edarn/kryp-client/Web/SurfVind_web/Surfvind/design/ws_speed.png

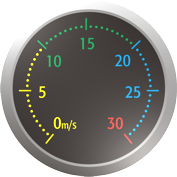
Web/SurfVind_web/Surfvind/design/ws_speed.png
