edarn/kryp-client/PCB/main_board_1_3 with gerbers/Gerber Files/INFO.txt

[B]Main board v1.3.GBL - copper bottom layer
[B]Main board v1.3.GTL - copper top layer
[B]Main board v1.3.GBS - soldermask bottom layer
[B]Main board v1.3.GTS - soldermask top layer
[B]Main board v1.3.GTO - silkscreen top layer
[B]Main board v1.3.GBO - silkscreen bottom layer
[B]Main board v1.3.gpi - gerber info

[B]Main board v1.3.drd - drill files
[B]Main board v1.3.dri - drill info
