edarn/kryp-client/Android/Logger/DataLogger/raw_images/tumblr_static_arrow.jpg

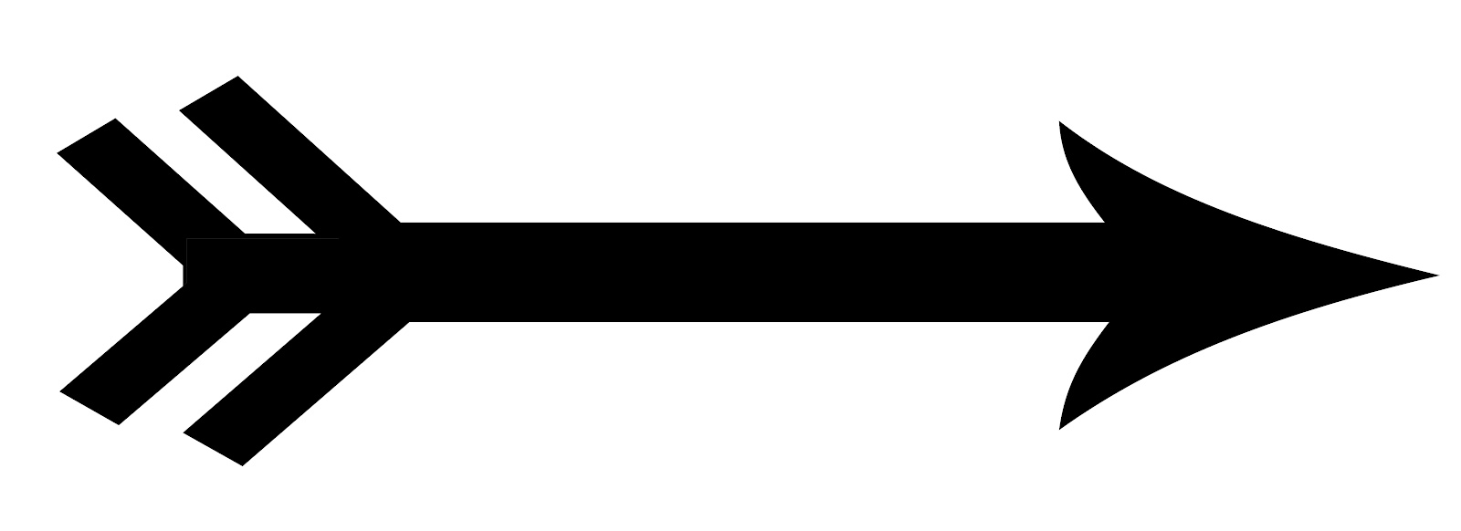
Android/Logger/DataLogger/raw_images/tumblr_static_arrow.jpg
