edarn/kryp-client/Android/Logger/DataLogger/raw_images/ws_compass.png

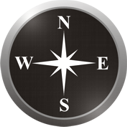
Android/Logger/DataLogger/raw_images/ws_compass.png
