edarn/kryp-client/Web/SurfVind_web/Surfvind/Applet/12345/graph_2.png

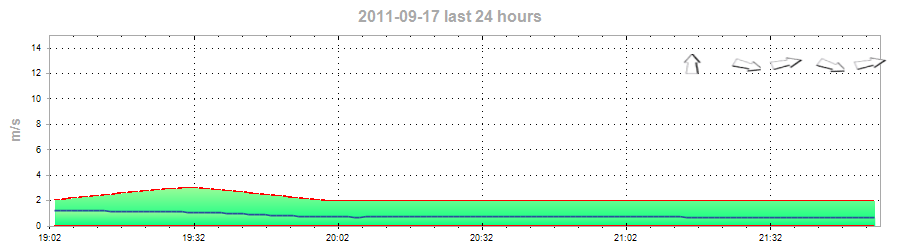
Web/SurfVind_web/Surfvind/Applet/12345/graph_2.png
