edarn/kryp-client/Web/SurfVind_web/Surfvind/Applet/354745031074596/graph_4.png

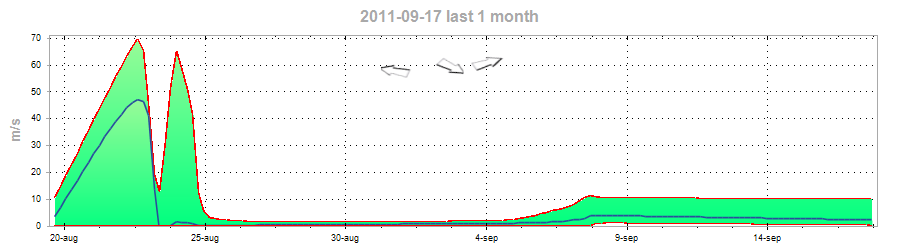
Web/SurfVind_web/Surfvind/Applet/354745031074596/graph_4.png
