edarn/kryp-client/Web/SurfVind_web/Surfvind/design/chart.png

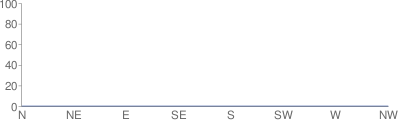
Web/SurfVind_web/Surfvind/design/chart.png
