edarn/kryp-client/Web/SurfVind_web/Surfvind/design/ws_background_sea.png

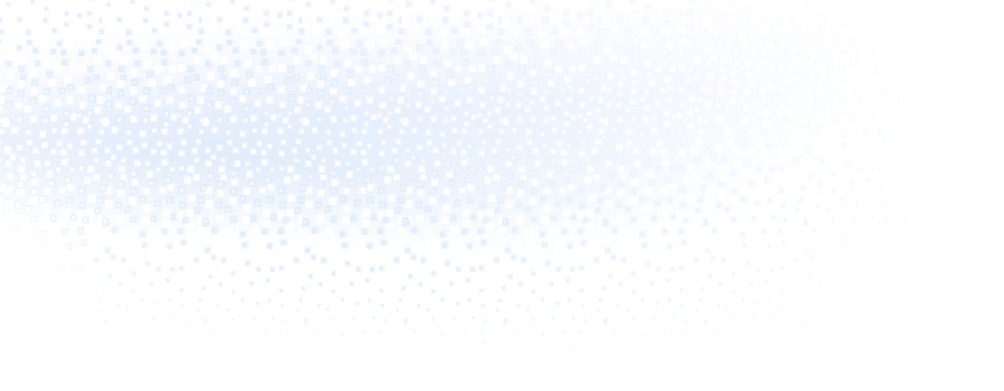
Web/SurfVind_web/Surfvind/design/ws_background_sea.png
