edarn/kryp-client/Web/SurfVind_web/Surfvind/design/ws_graph.png

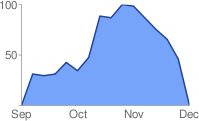
Web/SurfVind_web/Surfvind/design/ws_graph.png
