edarn/kryp-client/Web/SurfVind_web/Surfvind/design/ws_head.png

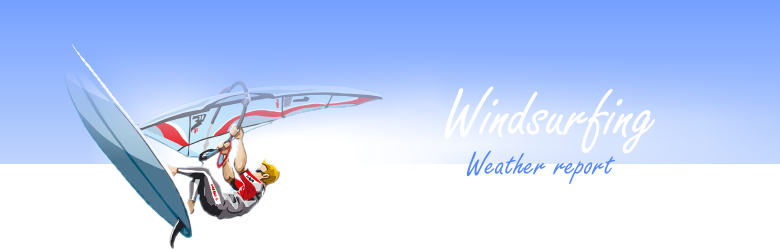
Web/SurfVind_web/Surfvind/design/ws_head.png
