edarn/kryp-client/Web/SurfVind_web/Surfvind/Images/12345_img_compass.png

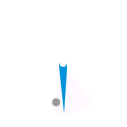
Web/SurfVind_web/Surfvind/Images/12345_img_compass.png
