edarn/kryp-client/Web/SurfVind_web/Surfvind/Images/12345_img_speed.png

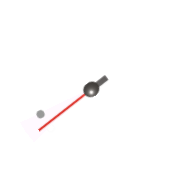
Web/SurfVind_web/Surfvind/Images/12345_img_speed.png
