edarn/kryp-client/Web/SurfVind_web/Surfvind/Images/12345_WindDirectionChart.png

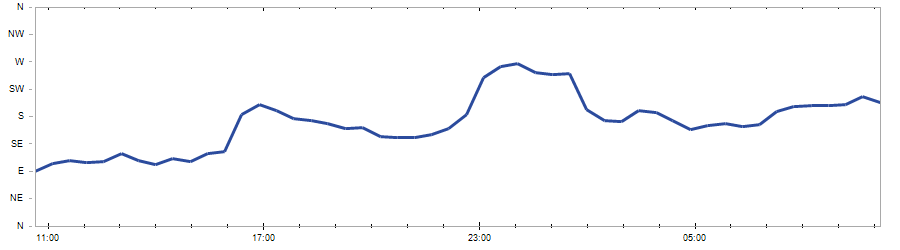
Web/SurfVind_web/Surfvind/Images/12345_WindDirectionChart.png
