edarn/kryp-client/Web/SurfVind_web/Surfvind/Images/12345_WindSpeedChart.png

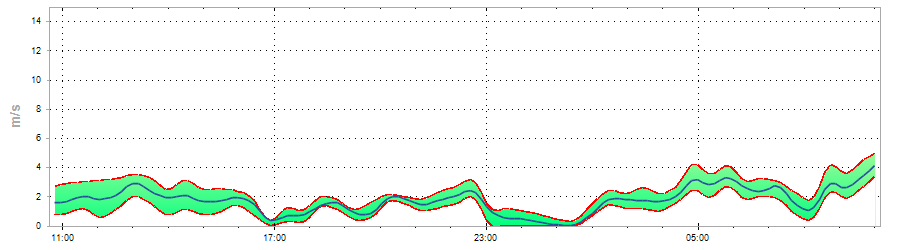
Web/SurfVind_web/Surfvind/Images/12345_WindSpeedChart.png
