edarn/kryp-client/Web/SurfVind_web/Surfvind/Images/354745030513008_img_compass.png

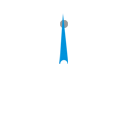
Web/SurfVind_web/Surfvind/Images/354745030513008_img_compass.png
