edarn/kryp-client/Web/SurfVind_web/Surfvind/Images/354745030513008_WindDirectionChart.png

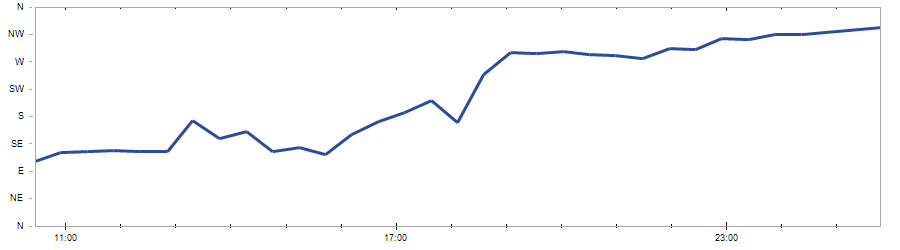
Web/SurfVind_web/Surfvind/Images/354745030513008_WindDirectionChart.png
