edarn/kryp-client/Web/SurfVind_web/Surfvind/Images/354745030513008_WindSpeedChart.png

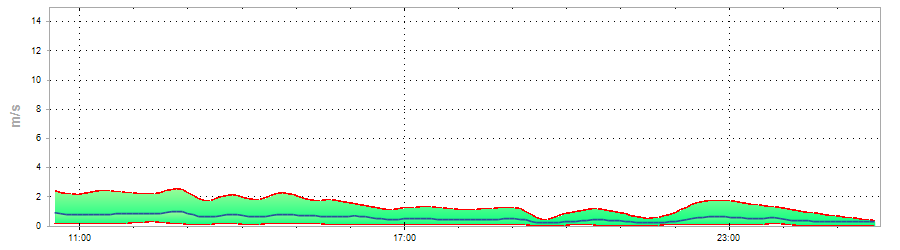
Web/SurfVind_web/Surfvind/Images/354745030513008_WindSpeedChart.png
