edarn/kryp-client/Web/SurfVind_web/Surfvind/Images/354745031035159_img_compass.png

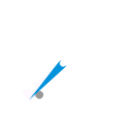
Web/SurfVind_web/Surfvind/Images/354745031035159_img_compass.png
