edarn/kryp-client/Web/SurfVind_web/Surfvind/Images/354745031074596_img_speed.png

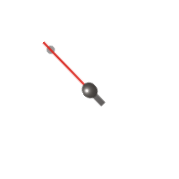
Web/SurfVind_web/Surfvind/Images/354745031074596_img_speed.png
