edarn/kryp-client/Web/SurfVind_web/Surfvind/Images/_WindDirectionChart.png

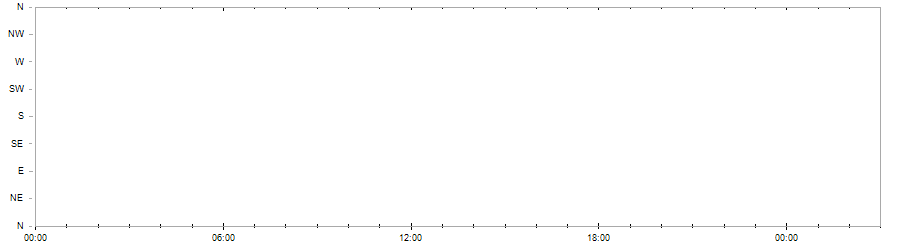
Web/SurfVind_web/Surfvind/Images/_WindDirectionChart.png
