edarn/kryp-client/Web/SurfVind_web/Surfvind/Images/img_compass.png

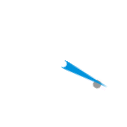
Web/SurfVind_web/Surfvind/Images/img_compass.png
