edarn/kryp-client/Web/SurfVind_web/Surfvind/Images/WindSpeedChart.png

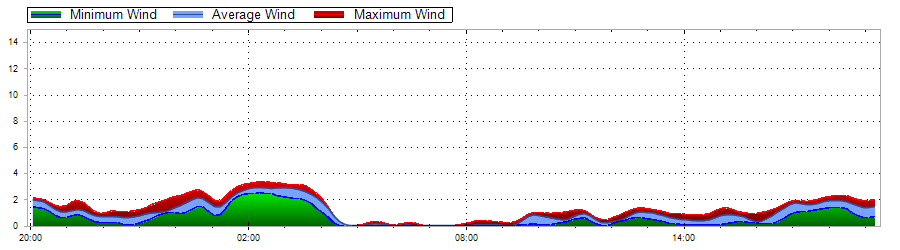
Web/SurfVind_web/Surfvind/Images/WindSpeedChart.png
