edarn/kryp-client/Web/Vindinfo_web/Applet/12345/graph_0.png

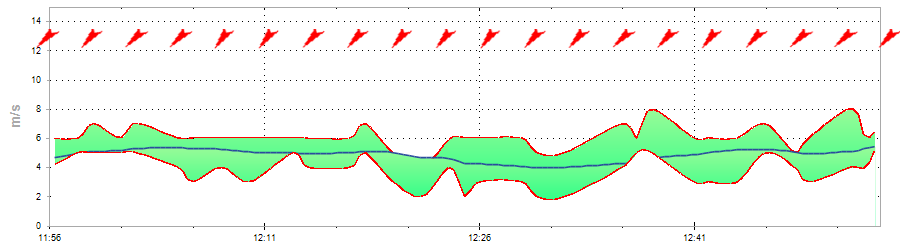
Web/Vindinfo_web/Applet/12345/graph_0.png
