edarn/kryp-client/Web/Vindinfo_web/Applet/12345/graph_4.png

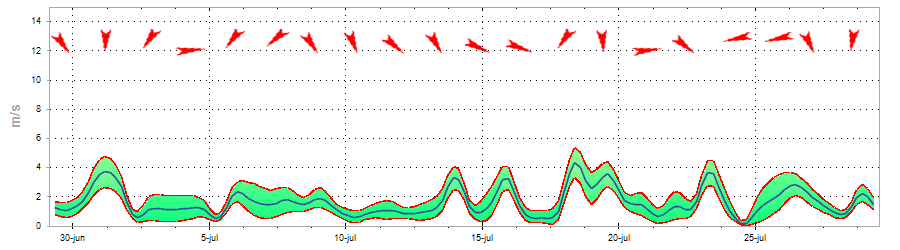
Web/Vindinfo_web/Applet/12345/graph_4.png
