edarn/kryp-client/Web/Vindinfo_web/Applet/354745030513008/graph_0.png

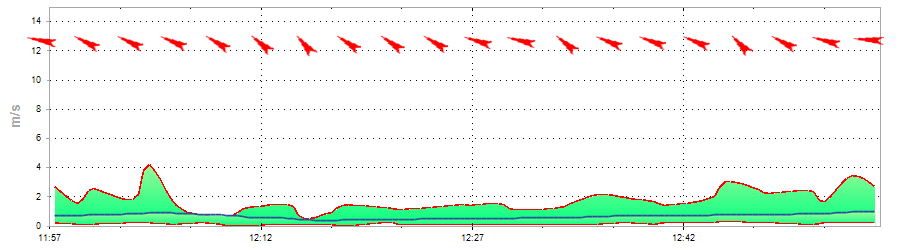
Web/Vindinfo_web/Applet/354745030513008/graph_0.png
