edarn/kryp-client/Web/Vindinfo_web/Applet/354745030513008/graph_4.png

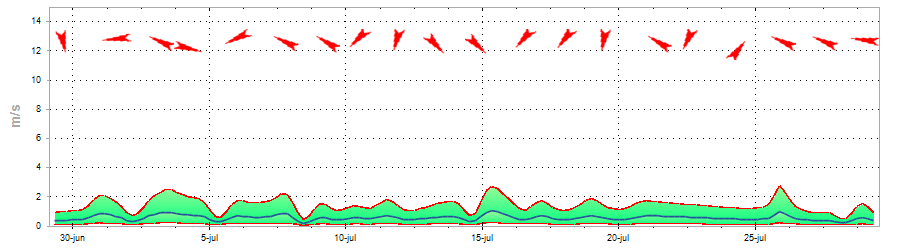
Web/Vindinfo_web/Applet/354745030513008/graph_4.png
