edarn/kryp-client/Web/Vindinfo_web/Applet/354745031035159/graph_4.png

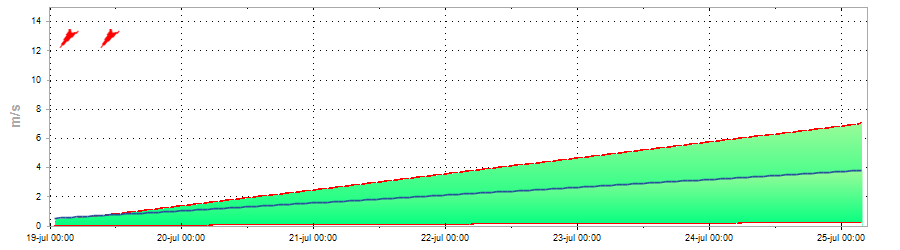
Web/Vindinfo_web/Applet/354745031035159/graph_4.png
