edarn/kryp-client/Web/Vindinfo_web/design/back.png

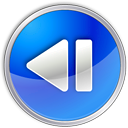
Web/Vindinfo_web/design/back.png
