edarn/kryp-client/Web/Vindinfo_web/design/flower.jpg

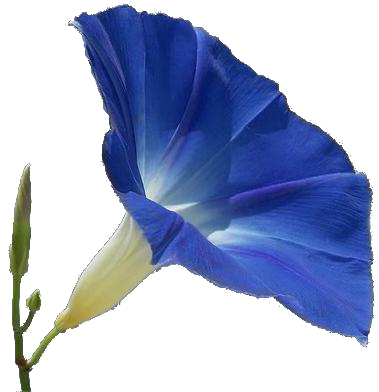
Web/Vindinfo_web/design/flower.jpg
