edarn/kryp-client/Web/Vindinfo_web/design/forward.png

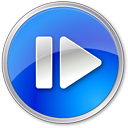
Web/Vindinfo_web/design/forward.png
