edarn/kryp-client/Web/Vindinfo_web/design/Weather.gif

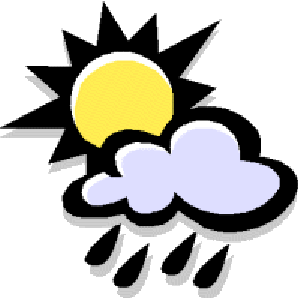
Web/Vindinfo_web/design/Weather.gif
