edarn/kryp-client/Web/Vindinfo_web/Images/12345_img_speed.png

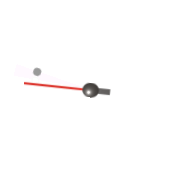
Web/Vindinfo_web/Images/12345_img_speed.png
