edarn/kryp-client/Web/Vindinfo_web/Images/354745030513008_img_compass.png

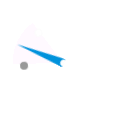
Web/Vindinfo_web/Images/354745030513008_img_compass.png
