edarn/kryp-client/Web/Vindinfo_web/Images/contacts_btn.png

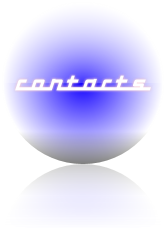
Web/Vindinfo_web/Images/contacts_btn.png
