edarn/kryp-client/Web/Vindinfo_web/Images/FunnyWeatherForecast.jpg

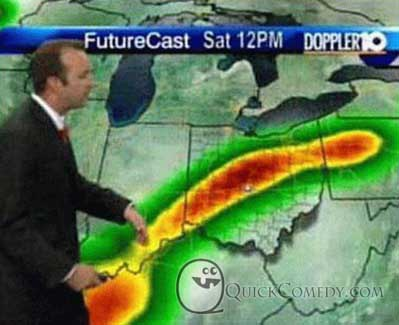
Web/Vindinfo_web/Images/FunnyWeatherForecast.jpg
