edarn/kryp-client/Web/Vindinfo_web/Images/header2.jpg

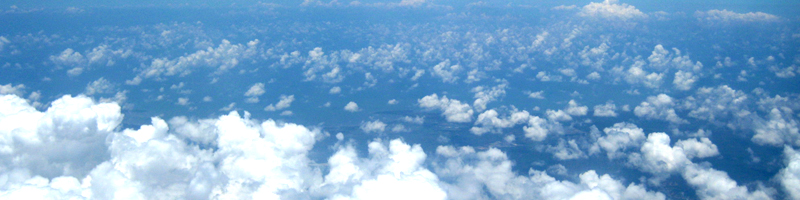
Web/Vindinfo_web/Images/header2.jpg
