edarn/kryp-client/Web/Vindinfo_web/Images/header.jpg

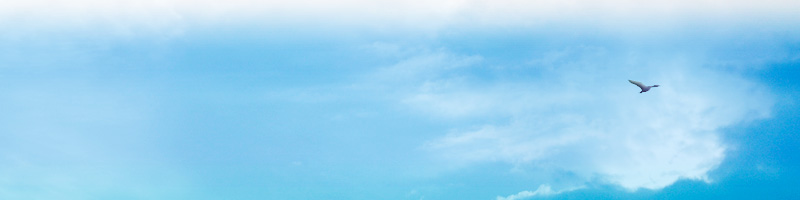
Web/Vindinfo_web/Images/header.jpg
