edarn/kryp-client/Web/Vindinfo_web/Images/kscn1141l.jpg

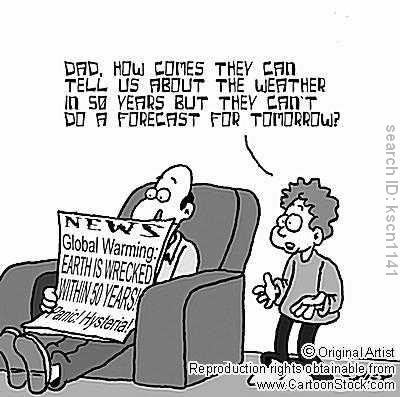
Web/Vindinfo_web/Images/kscn1141l.jpg
