edarn/kryp-client/Web/Vindinfo_web/Images/sun.png

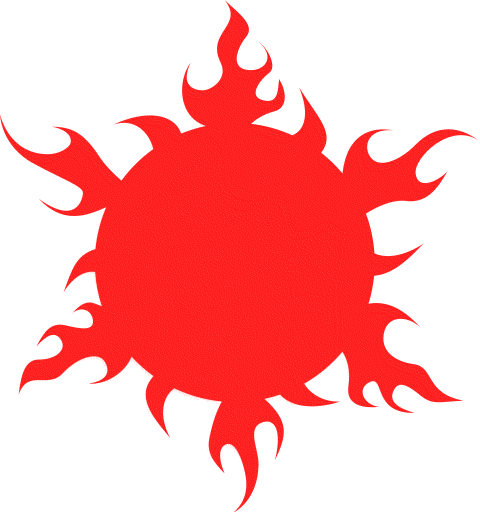
Web/Vindinfo_web/Images/sun.png
