edarn/kryp-client/Web/Vindinfo_web/Images/sun_weather.PNG

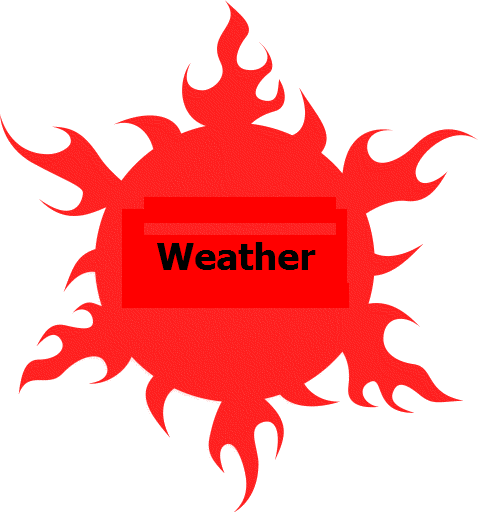
Web/Vindinfo_web/Images/sun_weather.PNG
