edarn/kryp-client/Web/Vindinfo_web/Images/welcome_page1.PNG

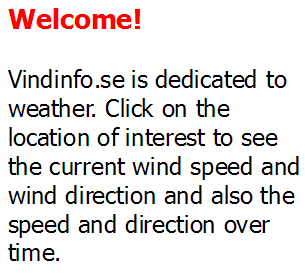
Web/Vindinfo_web/Images/welcome_page1.PNG
