edarn/kryp-client/Web/Vindinfo_web/Images/welcome_page.PNG

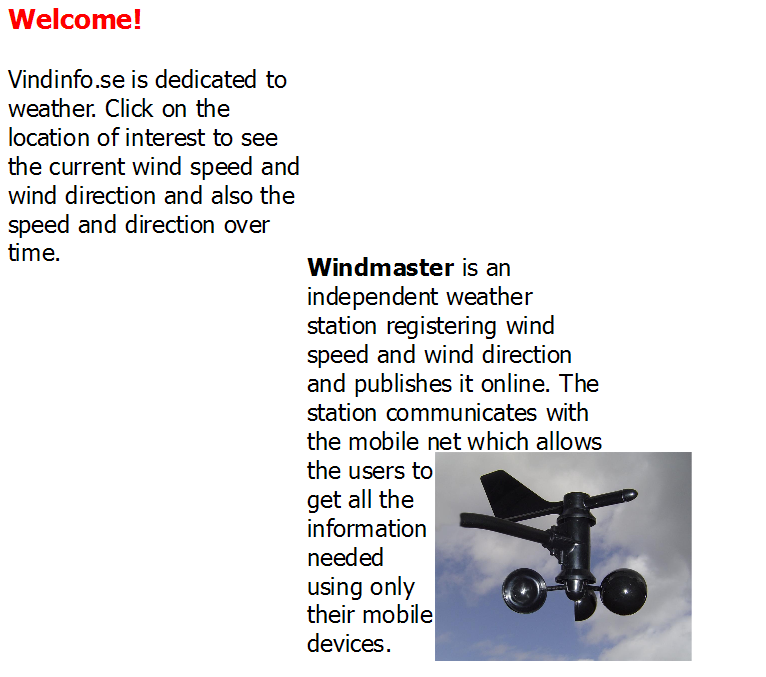
Web/Vindinfo_web/Images/welcome_page.PNG
