edarn/kryp-client/Web/Vindinfo_web/Images/welcome_pic.jpg

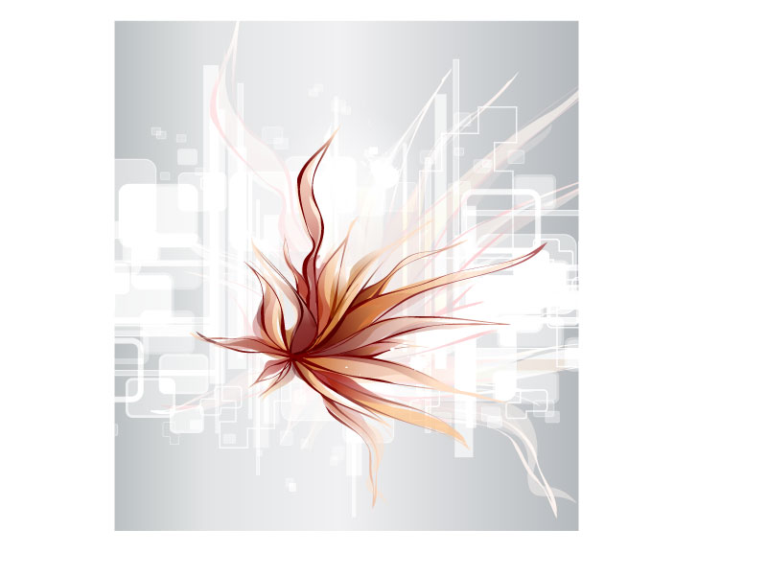
Web/Vindinfo_web/Images/welcome_pic.jpg
