edarn/kryp-client/Web/Vindinfo_web/Images/windmaster1.PNG

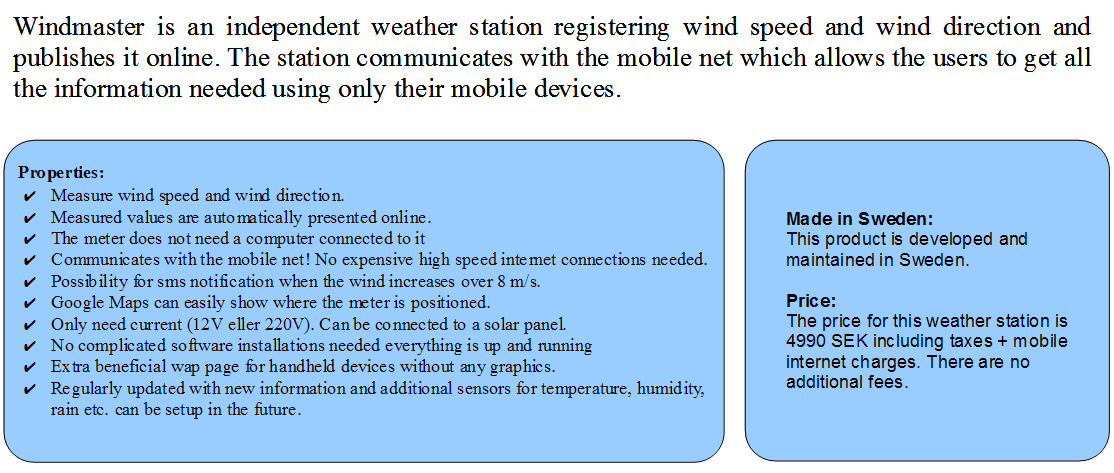
Web/Vindinfo_web/Images/windmaster1.PNG
