edarn/kryp-client/Web/Vindinfo_web/Images/windmaster2.PNG

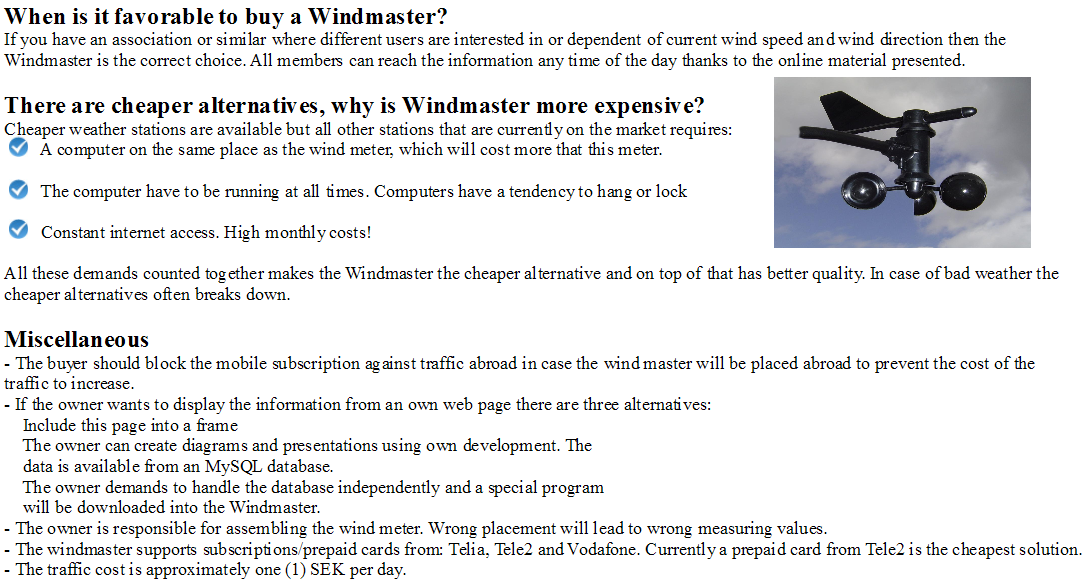
Web/Vindinfo_web/Images/windmaster2.PNG
