edarn/kryp-client/PCB/BOM_Main board v1.3 rev0.1.xls

Sheet: Main board v1.3.xls]I2C
Part | Value | Device | Package | Description | Vendors | Link1
C2 | 10u | C-EUC1206 | C1206 | CAPACITOR, European symbol | TME | http://www.tme.eu/pl/details/c1206c106k4rac/kondensatory-mlcc-smd-1206/kemet/#
C3 | 10u | C-EUC1206 | C1206 | CAPACITOR, European symbol | TME | http://www.tme.eu/pl/details/c1206c106k4rac/kondensatory-mlcc-smd-1206/kemet/#
C4 | 10u | C-EUC1206 | C1206 | CAPACITOR, European symbol | TME | http://www.tme.eu/pl/details/c1206c106k4rac/kondensatory-mlcc-smd-1206/kemet/#
C5 | 100uF/25V | CPOL-EUE2-5 | E2-5 | POLARIZED CAPACITOR, European symbol | TME | http://www.tme.eu/pl/details/sd1e107m05011pc/kondensatory-85c/samwha/#
C11 | 10uF | C-EUC1206 | C1206 | CAPACITOR, European symbol | TME | http://www.tme.eu/pl/details/c1206c106k4rac/kondensatory-mlcc-smd-1206/kemet/#
C12 | 3n3 | C-EUC1206 | C1206 | CAPACITOR, European symbol | TME | http://www.tme.eu/pl/details/12065c332kat2a/kondensatory-mlcc-smd-1206/avx/#
C13 | 10uF | C-EUC1206 | C1206 | CAPACITOR, European symbol | TME | http://www.tme.eu/pl/details/c1206c106k4rac/kondensatory-mlcc-smd-1206/kemet/#
C16 | 10uF | C-EUC1206 | C1206 | CAPACITOR, European symbol | TME | http://www.tme.eu/pl/details/c1206c106k4rac/kondensatory-mlcc-smd-1206/kemet/#
C17 | 100uF/10V/tantal_B | CPOL-EUB/3528-21R | B/3528-21R | POLARIZED CAPACITOR, European symbol | TME | http://www.tme.eu/pl/details/tajb107m010r/kondensatory-tantalowe-smd/avx/tajb107m010rnj/#
C18 | 100n | C-EUC1206 | C1206 | CAPACITOR, European symbol | TME | http://www.tme.eu/pl/details/cl31b104kbcnnnc/kondensatory-mlcc-smd-1206/samsung/#
C19 | 10n | C-EUC1206 | C1206 | CAPACITOR, European symbol | TME | http://www.tme.eu/pl/details/cl31b103kbcnnnc/kondensatory-mlcc-smd-1206/samsung/#
C20 | 100n | C-EUC1206 | C1206 | CAPACITOR, European symbol | TME | http://www.tme.eu/pl/details/cl31b104kbcnnnc/kondensatory-mlcc-smd-1206/samsung/#
C21 | 100n | C-EUC1206 | C1206 | CAPACITOR, European symbol | TME | http://www.tme.eu/pl/details/cl31b104kbcnnnc/kondensatory-mlcc-smd-1206/samsung/#
C22 | 100n | C-EUC1206 | C1206 | CAPACITOR, European symbol | TME | http://www.tme.eu/pl/details/cl31b104kbcnnnc/kondensatory-mlcc-smd-1206/samsung/#
C23 | 100n | C-EUC1206 | C1206 | CAPACITOR, European symbol | TME | http://www.tme.eu/pl/details/cl31b104kbcnnnc/kondensatory-mlcc-smd-1206/samsung/#
C24 | 10uF | C-EUC1206 | C1206 | CAPACITOR, European symbol | TME | http://www.tme.eu/pl/details/c1206c106k4rac/kondensatory-mlcc-smd-1206/kemet/#
C25 | 100n | C-EUC1206 | C1206 | CAPACITOR, European symbol | TME | http://www.tme.eu/pl/details/cl31b104kbcnnnc/kondensatory-mlcc-smd-1206/samsung/#
D1 | 1N4004 | 1N4004 | DO41-10 | DIODE | TME | http://www.tme.eu/pl/details/1n4004/diody-uniwersalne-tht/dc-components/#
D2 | 1N4148DO35-7 | 1N4148DO35-7 | DO35-7 | DIODE | TME | http://www.tme.eu/pl/details/1n4148/diody-uniwersalne-tht/nxp/1n4148113/#
D3 | SS14 | DIODE-SCHOTTKY_ | SMA-DIODE | Commonly MBRA140. | TME | http://www.tme.eu/pl/details/ss14/diody-schottky-smd/dc-components/#
D4 | 1N4148DO35-7 | 1N4148DO35-7 | DO35-7 | DIODE | TME | http://www.tme.eu/pl/details/1n4148/diody-uniwersalne-tht/nxp/1n4148113/#
F1 |  | FUSE_HOLDER | ZHL30 |  | TME | http://www.tme.eu/pl/details/zhl30/bezpieczniki-gniazda-pcb/#t735977d29e6b3d766657895563ce61ae
F2 |  | FUSE_HOLDER | ZHL30 |  | TME | http://www.tme.eu/pl/details/zhl30/bezpieczniki-gniazda-pcb/#t735977d29e6b3d766657895563ce61ae
F3 | PTCSMD | PTCSMD | PTC-1206 | Resettable Fuse PTC | TME | http://www.tme.eu/pl/details/sn075-06/bezpieczniki-polimerowe-smd/ece/#
J1 | 6P_CONN | 6P_CONN | MOLEX_39543-0006 |  | farnell | http://se.farnell.com/molex/39543-0006/terminal-block-eurostyle-6pos-24/dp/1368505?Ntt=1368505
J3 | POWER_JACKPTH | POWER_JACKPTH | PC-GK2.1 | Power Jack | TME | http://www.tme.eu/pl/details/pc-gk2.1/zlacza-dc/#
J4 | RJ11MX-95001-2661 | RJ11MX-95001-2661 | MX-95001-2661 | CORCOM Modular RJ Jacks No Shield | ELFA | https://www.elfa.se/elfa3~se_sv/elfa/init.do?item=42-696-27&toc=0&q=42-696-27
J5 | RJ11MX-95001-2661 | RJ11MX-95001-2661 | MX-95001-2661 | CORCOM Modular RJ Jacks No Shield | ELFA | https://www.elfa.se/elfa3~se_sv/elfa/init.do?item=42-696-27&toc=0&q=42-696-27
J6 | RJ11MX-95001-2661 | RJ11MX-95001-2661 | MX-95001-2661 | CORCOM Modular RJ Jacks No Shield | ELFA | https://www.elfa.se/elfa3~se_sv/elfa/init.do?item=42-696-27&toc=0&q=42-696-27
J7 | 10104111-0001LF | USB_AB | USB-AB-MICRO-SMD | This is a USB AB connector that is compatible with USB OTG. | Mouser | http://pl.mouser.com/ProductDetail/FCI/10104111-0001LF/
JP3 |  | JUMPER-2PTH | 1X02 | Jumper | TME | http://www.tme.eu/pl/details/zl209-40p/listwy-i-gniazda-kolkowe/connfly/ds1021-1_40sf1-5/#
JP4 |  | MA06-1 | MA06-1 | PIN HEADER | TME | http://www.tme.eu/pl/details/zl209-40p/listwy-i-gniazda-kolkowe/connfly/ds1021-1_40sf1-5/#
JP5 |  | JUMPER-2PTH | 1X02 | Jumper | TME | http://www.tme.eu/pl/details/zl209-40p/listwy-i-gniazda-kolkowe/connfly/ds1021-1_40sf1-5/#
K1 | RELAY | RELAY | JV-5S-KT | JV-5S-KT | TME | http://www.tme.eu/pl/details/jv-5s-kt/przekazniki-elektromagn-miniaturowe/fujitsu-takamisawa/#
K2 | RELAY | RELAY | JV-5S-KT | JV-5S-KT | TME | http://www.tme.eu/pl/details/jv-5s-kt/przekazniki-elektromagn-miniaturowe/fujitsu-takamisawa/#
L1 | VLC5045T-3R3N, 3.3uH | INDUCTORCR54 | CR54 | Inductors | Mouser | http://pl.mouser.com/ProductDetail/TDK/VLC5045T-3R3N/
L2 | 30Ohm ,3A | L-US | R1206 | INDUCTOR, American symbol | Mouser | http://pl.mouser.com/ProductDetail/Fair-Rite/2512063007Y0/
LED1 | LS L29K-G1J2-1-Z | LED1206 | LED-1206 | LEDs | TME | http://www.tme.eu/pl/details/osr51206c1c/diody-led-smd-1206/optosupply/#
LED2 | LY L29K-J1K2-26-Z | LED1206 | LED-1206 | LEDs | TME | http://www.tme.eu/pl/details/osr51206c1c/diody-led-smd-1206/optosupply/#
R6 | 0R | R-EU_R1206 | R1206 | RESISTOR, European symbol | TME | http://www.tme.eu/pl/details/rc1206jr-070r/rezystory-smd-1206/yageo/rc1206jr-070rl/#
R7 | 0R | R-EU_R1206 | R1206 | RESISTOR, European symbol | TME | http://www.tme.eu/pl/details/rc1206jr-070r/rezystory-smd-1206/yageo/rc1206jr-070rl/#
R8 | 0R | R-EU_R1206 | R1206 | RESISTOR, European symbol | TME | http://www.tme.eu/pl/details/rc1206jr-070r/rezystory-smd-1206/yageo/rc1206jr-070rl/#
R9 | 0R | R-EU_R1206 | R1206 | RESISTOR, European symbol | TME | http://www.tme.eu/pl/details/rc1206jr-070r/rezystory-smd-1206/yageo/rc1206jr-070rl/#
R10 | 0R | R-EU_R1206 | R1206 | RESISTOR, European symbol | TME | http://www.tme.eu/pl/details/rc1206jr-070r/rezystory-smd-1206/yageo/rc1206jr-070rl/#
R11 | 0R | R-EU_R1206 | R1206 | RESISTOR, European symbol | TME | http://www.tme.eu/pl/details/rc1206jr-070r/rezystory-smd-1206/yageo/rc1206jr-070rl/#
R16 | 24k | R-EU_R1206 | R1206 | RESISTOR, European symbol | TME | http://www.tme.eu/pl/details/rc1206jr-0724k/rezystory-smd-1206/yageo/rc1206jr-0724kl/#
R17 | 4k7 | R-EU_R1206 | R1206 | RESISTOR, European symbol | TME | http://www.tme.eu/pl/details/smd1206-4k7/rezystory-smd-1206/royal-ohm/1206s4j0472t5e/#
R18 | 1k | R-EU_R1206 | R1206 | RESISTOR, European symbol | TME | http://www.tme.eu/pl/details/rc1206jr-071k/rezystory-smd-1206/yageo/rc1206jr-071kl/#
R19 | 4k7 | R-EU_R1206 | R1206 | RESISTOR, European symbol | TME | http://www.tme.eu/pl/details/smd1206-4k7/rezystory-smd-1206/royal-ohm/1206s4j0472t5e/#
R20 | 4k7 | R-EU_R1206 | R1206 | RESISTOR, European symbol | TME | http://www.tme.eu/pl/details/smd1206-4k7/rezystory-smd-1206/royal-ohm/1206s4j0472t5e/#
R21 | 1k | R-EU_R1206 | R1206 | RESISTOR, European symbol | TME | http://www.tme.eu/pl/details/rc1206jr-071k/rezystory-smd-1206/yageo/rc1206jr-071kl/#
R22 | 1k | R-EU_R1206 | R1206 | RESISTOR, European symbol | TME | http://www.tme.eu/pl/details/rc1206jr-071k/rezystory-smd-1206/yageo/rc1206jr-071kl/#
R23 | 100k | R-EU_R1206 | R1206 | RESISTOR, European symbol | TME | http://www.tme.eu/pl/details/rc1206jr-07100k/rezystory-smd-1206/yageo/rc1206jr-07100kl/#
R24 | 4k7 | R-EU_R1206 | R1206 | RESISTOR, European symbol | TME | http://www.tme.eu/pl/details/smd1206-4k7/rezystory-smd-1206/royal-ohm/1206s4j0472t5e/#
R25 | 2k | R-EU_R1206 | R1206 | RESISTOR, European symbol | TME | http://www.tme.eu/pl/details/rc1206jr-072k/rezystory-smd-1206/yageo/rc1206jr-072kl/#
R26 | 470R | R-EU_R1206 | R1206 | RESISTOR, European symbol | TME | http://www.tme.eu/pl/details/rc1206jr-07470r/rezystory-smd-1206/yageo/rc1206jr-07470rl/#
R27 | 100k | R-EU_R1206 | R1206 | RESISTOR, European symbol | TME | http://www.tme.eu/pl/details/rc1206jr-07100k/rezystory-smd-1206/yageo/rc1206jr-07100kl/#
R28 | 10M | R-EU_R1206 | R1206 | RESISTOR, European symbol | TME | http://www.tme.eu/pl/details/smd1206-10m/rezystory-smd-1206/royal-ohm/1206s4j-10m-t5e/#
R29 | 4k7 | R-EU_R1206 | R1206 | RESISTOR, European symbol | TME | http://www.tme.eu/pl/details/smd1206-4k7/rezystory-smd-1206/royal-ohm/1206s4j0472t5e/# | http://www.tme.eu/pl/details/smd1206-4k7/rezystory-smd-1206/royal-ohm/1206s4j0472t5e/#
R30 | 4k7 | R-EU_R1206 | R1206 | RESISTOR, European symbol | TME | http://www.tme.eu/pl/details/smd1206-4k7/rezystory-smd-1206/royal-ohm/1206s4j0472t5e/# | http://www.tme.eu/pl/details/smd1206-4k7/rezystory-smd-1206/royal-ohm/1206s4j0472t5e/#
R31 | 4k7 | R-EU_R1206 | R1206 | RESISTOR, European symbol | TME | http://www.tme.eu/pl/details/smd1206-4k7/rezystory-smd-1206/royal-ohm/1206s4j0472t5e/#
R32 | 4k7 | R-EU_R1206 | R1206 | RESISTOR, European symbol | TME | http://www.tme.eu/pl/details/smd1206-4k7/rezystory-smd-1206/royal-ohm/1206s4j0472t5e/#
R33 | 4k7 | R-EU_R1206 | R1206 | RESISTOR, European symbol | TME | http://www.tme.eu/pl/details/smd1206-4k7/rezystory-smd-1206/royal-ohm/1206s4j0472t5e/#
R34 | 4k7 | R-EU_R1206 | R1206 | RESISTOR, European symbol | TME | http://www.tme.eu/pl/details/smd1206-4k7/rezystory-smd-1206/royal-ohm/1206s4j0472t5e/#
R35 | 4k7 | R-EU_R1206 | R1206 | RESISTOR, European symbol | TME | http://www.tme.eu/pl/details/smd1206-4k7/rezystory-smd-1206/royal-ohm/1206s4j0472t5e/#
R36 | 470R | R-EU_R1206 | R1206 | RESISTOR, European symbol | TME | http://www.tme.eu/pl/details/rc1206jr-07470r/rezystory-smd-1206/yageo/rc1206jr-07470rl/#
R38 | 1k | R-EU_R1206 | R1206 | RESISTOR, European symbol | TME | http://www.tme.eu/pl/details/rc1206jr-071k/rezystory-smd-1206/yageo/rc1206jr-071kl/#
SV1 |  | MA04-1 | MA04-1 | PIN HEADER | TME | http://www.tme.eu/pl/details/zl209-40p/listwy-i-gniazda-kolkowe/connfly/ds1021-1_40sf1-5/#
SV2 |  | MA04-1 | MA04-1 | PIN HEADER | TME | http://www.tme.eu/pl/details/zl209-40p/listwy-i-gniazda-kolkowe/connfly/ds1021-1_40sf1-5/#
SV3 |  | MA04-1 | MA04-1 | PIN HEADER | TME | http://www.tme.eu/pl/details/zl209-40p/listwy-i-gniazda-kolkowe/connfly/ds1021-1_40sf1-5/#
T1 | BC817 | BC817-16-NPN-SOT23-BEC | SOT23-BEC | NPN Transistror | TME | http://www.tme.eu/pl/details/bc817-16/tranzystory-npn-smd/#
T2 | BC817 | BC817-16-NPN-SOT23-BEC | SOT23-BEC | NPN Transistror | TME | http://www.tme.eu/pl/details/bc817-16/tranzystory-npn-smd/#
T3 | IRLML2244 | MOSFET-PCHANNELSMD | SOT23-3 | Generic PMOSFET | TME | http://www.tme.eu/pl/details/irlml2244trpbf/tranzystory-z-kanalem-p-smd/international-rectifier/#
T4 | 2N7002PW | MOSFET-NCHANNELSOT323 | SOT323 | Generic NMOS footprint | Mouser | http://pl.mouser.com/ProductDetail/NXP/2N7002PW115/
U4 | VREG_MIC5216 | VREG_MIC5216 | MSOP8 | 500mA LDO, MSOP8 for better dissipation | Mouser | http://pl.mouser.com/ProductDetail/Micrel/MIC5216-33YMM/
U5 | TPS62133RGTT | TPS6214X | QFN16-3X3MM | 3-17V, 2A Step Down Converter | Mouser | http://pl.mouser.com/ProductDetail/Texas-Instruments/TPS62133RGTT/
U7 | PIC24FJ256GB206 | PIC24FXXXDAX06 | PIC24FXXX_TQFP64 | PIC24FXXXDAX06 | Mouser | http://pl.mouser.com/ProductDetail/Microchip-Technology/PIC24FJ256GB206-I-PT/
U8 | LMC555 | LMC555 | SO08 | General purpose Timer | TME | http://www.tme.eu/pl/details/lmc555cm_nopb/uklady-watchdog-i-reset/texas-instruments/#

Sheet: Main board v1.3.xls]I2C extended
Part | Value | Device | Package | Description | Vendors | Link1
C2 | 10u | C-EUC1206 | C1206 | CAPACITOR, European symbol | TME | http://www.tme.eu/pl/details/c1206c106k4rac/kondensatory-mlcc-smd-1206/kemet/#
C3 | 10u | C-EUC1206 | C1206 | CAPACITOR, European symbol | TME | http://www.tme.eu/pl/details/c1206c106k4rac/kondensatory-mlcc-smd-1206/kemet/#
C4 | 10u | C-EUC1206 | C1206 | CAPACITOR, European symbol | TME | http://www.tme.eu/pl/details/c1206c106k4rac/kondensatory-mlcc-smd-1206/kemet/#
C5 | 100uF/25V | CPOL-EUE2-5 | E2-5 | POLARIZED CAPACITOR, European symbol | TME | http://www.tme.eu/pl/details/sd1e107m05011pc/kondensatory-85c/samwha/#
C8 | 100n | C-EUC1206 | C1206 | CAPACITOR, European symbol | TME | http://www.tme.eu/pl/details/cl31b104kbcnnnc/kondensatory-mlcc-smd-1206/samsung/#
C9 | 100n | C-EUC1206 | C1206 | CAPACITOR, European symbol | TME | http://www.tme.eu/pl/details/cl31b104kbcnnnc/kondensatory-mlcc-smd-1206/samsung/#
C10 | 100n | C-EUC1206 | C1206 | CAPACITOR, European symbol | TME | http://www.tme.eu/pl/details/cl31b104kbcnnnc/kondensatory-mlcc-smd-1206/samsung/#
C11 | 10uF | C-EUC1206 | C1206 | CAPACITOR, European symbol | TME | http://www.tme.eu/pl/details/c1206c106k4rac/kondensatory-mlcc-smd-1206/kemet/#
C12 | 3n3 | C-EUC1206 | C1206 | CAPACITOR, European symbol | TME | http://www.tme.eu/pl/details/12065c332kat2a/kondensatory-mlcc-smd-1206/avx/#
C13 | 10uF | C-EUC1206 | C1206 | CAPACITOR, European symbol | TME | http://www.tme.eu/pl/details/c1206c106k4rac/kondensatory-mlcc-smd-1206/kemet/#
C16 | 10uF | C-EUC1206 | C1206 | CAPACITOR, European symbol | TME | http://www.tme.eu/pl/details/c1206c106k4rac/kondensatory-mlcc-smd-1206/kemet/#
C17 | 100uF/10V/tantal_B | CPOL-EUB/3528-21R | B/3528-21R | POLARIZED CAPACITOR, European symbol | TME | http://www.tme.eu/pl/details/tajb107m010r/kondensatory-tantalowe-smd/avx/tajb107m010rnj/#
C18 | 100n | C-EUC1206 | C1206 | CAPACITOR, European symbol | TME | http://www.tme.eu/pl/details/cl31b104kbcnnnc/kondensatory-mlcc-smd-1206/samsung/#
C19 | 10n | C-EUC1206 | C1206 | CAPACITOR, European symbol | TME | http://www.tme.eu/pl/details/cl31b103kbcnnnc/kondensatory-mlcc-smd-1206/samsung/#
C20 | 100n | C-EUC1206 | C1206 | CAPACITOR, European symbol | TME | http://www.tme.eu/pl/details/cl31b104kbcnnnc/kondensatory-mlcc-smd-1206/samsung/#
C21 | 100n | C-EUC1206 | C1206 | CAPACITOR, European symbol | TME | http://www.tme.eu/pl/details/cl31b104kbcnnnc/kondensatory-mlcc-smd-1206/samsung/#
C22 | 100n | C-EUC1206 | C1206 | CAPACITOR, European symbol | TME | http://www.tme.eu/pl/details/cl31b104kbcnnnc/kondensatory-mlcc-smd-1206/samsung/#
C23 | 100n | C-EUC1206 | C1206 | CAPACITOR, European symbol | TME | http://www.tme.eu/pl/details/cl31b104kbcnnnc/kondensatory-mlcc-smd-1206/samsung/#
C24 | 10uF | C-EUC1206 | C1206 | CAPACITOR, European symbol | TME | http://www.tme.eu/pl/details/c1206c106k4rac/kondensatory-mlcc-smd-1206/kemet/#
C25 | 100n | C-EUC1206 | C1206 | CAPACITOR, European symbol | TME | http://www.tme.eu/pl/details/cl31b104kbcnnnc/kondensatory-mlcc-smd-1206/samsung/#
D1 | 1N4004 | 1N4004 | DO41-10 | DIODE | TME | http://www.tme.eu/pl/details/1n4004/diody-uniwersalne-tht/dc-components/#
D2 | 1N4148DO35-7 | 1N4148DO35-7 | DO35-7 | DIODE | TME | http://www.tme.eu/pl/details/1n4148/diody-uniwersalne-tht/nxp/1n4148113/#
D3 | SS14 | DIODE-SCHOTTKY_ | SMA-DIODE | Commonly MBRA140. | TME | http://www.tme.eu/pl/details/ss14/diody-schottky-smd/dc-components/#
D4 | 1N4148DO35-7 | 1N4148DO35-7 | DO35-7 | DIODE | TME | http://www.tme.eu/pl/details/1n4148/diody-uniwersalne-tht/nxp/1n4148113/#
F1 |  | FUSE_HOLDER | ZHL30 |  | TME | http://www.tme.eu/pl/details/zhl30/bezpieczniki-gniazda-pcb/#t735977d29e6b3d766657895563ce61ae
F2 |  | FUSE_HOLDER | ZHL30 |  | TME | http://www.tme.eu/pl/details/zhl30/bezpieczniki-gniazda-pcb/#t735977d29e6b3d766657895563ce61ae
F3 | PTCSMD | PTCSMD | PTC-1206 | Resettable Fuse PTC | TME | http://www.tme.eu/pl/details/sn075-06/bezpieczniki-polimerowe-smd/ece/#
J1 | 6P_CONN | 6P_CONN | MOLEX_39543-0006 |  | farnell | http://se.farnell.com/molex/39543-0006/terminal-block-eurostyle-6pos-24/dp/1368505?Ntt=1368505
J3 | POWER_JACKPTH | POWER_JACKPTH | PC-GK2.1 | Power Jack | TME | http://www.tme.eu/pl/details/pc-gk2.1/zlacza-dc/#
J4 | RJ11MX-95001-2661 | RJ11MX-95001-2661 | MX-95001-2661 | CORCOM Modular RJ Jacks No Shield | ELFA | https://www.elfa.se/elfa3~se_sv/elfa/init.do?item=42-696-27&toc=0&q=42-696-27
J5 | RJ11MX-95001-2661 | RJ11MX-95001-2661 | MX-95001-2661 | CORCOM Modular RJ Jacks No Shield | ELFA | https://www.elfa.se/elfa3~se_sv/elfa/init.do?item=42-696-27&toc=0&q=42-696-27
J6 | RJ11MX-95001-2661 | RJ11MX-95001-2661 | MX-95001-2661 | CORCOM Modular RJ Jacks No Shield | ELFA | https://www.elfa.se/elfa3~se_sv/elfa/init.do?item=42-696-27&toc=0&q=42-696-27
J7 | 10104111-0001LF | USB_AB | USB-AB-MICRO-SMD | This is a USB AB connector that is compatible with USB OTG. | Mouser | http://pl.mouser.com/ProductDetail/FCI/10104111-0001LF/
JP3 |  | JUMPER-2PTH | 1X02 | Jumper | TME | http://www.tme.eu/pl/details/zl209-40p/listwy-i-gniazda-kolkowe/connfly/ds1021-1_40sf1-5/#
JP4 |  | MA06-1 | MA06-1 | PIN HEADER | TME | http://www.tme.eu/pl/details/zl209-40p/listwy-i-gniazda-kolkowe/connfly/ds1021-1_40sf1-5/#
JP5 |  | JUMPER-2PTH | 1X02 | Jumper | TME | http://www.tme.eu/pl/details/zl209-40p/listwy-i-gniazda-kolkowe/connfly/ds1021-1_40sf1-5/#
K1 | RELAY | RELAY | JV-5S-KT | JV-5S-KT | TME | http://www.tme.eu/pl/details/jv-5s-kt/przekazniki-elektromagn-miniaturowe/fujitsu-takamisawa/#
K2 | RELAY | RELAY | JV-5S-KT | JV-5S-KT | TME | http://www.tme.eu/pl/details/jv-5s-kt/przekazniki-elektromagn-miniaturowe/fujitsu-takamisawa/#
L1 | VLC5045T-3R3N, 3.3uH | INDUCTORCR54 | CR54 | Inductors | Mouser | http://pl.mouser.com/ProductDetail/TDK/VLC5045T-3R3N/
L2 | 30Ohm ,3A | L-US | R1206 | INDUCTOR, American symbol | Mouser | http://pl.mouser.com/ProductDetail/Fair-Rite/2512063007Y0/
LED1 | LS L29K-G1J2-1-Z | LED1206 | LED-1206 | LEDs | TME | http://www.tme.eu/pl/details/osr51206c1c/diody-led-smd-1206/optosupply/#
LED2 | LY L29K-J1K2-26-Z | LED1206 | LED-1206 | LEDs | TME | http://www.tme.eu/pl/details/osr51206c1c/diody-led-smd-1206/optosupply/#
R2 | 2k | R-EU_R1206 | R1206 | RESISTOR, European symbol | TME | http://www.tme.eu/pl/details/rc1206jr-072k/rezystory-smd-1206/yageo/rc1206jr-072kl/#
R3 | 2k | R-EU_R1206 | R1206 | RESISTOR, European symbol | TME | http://www.tme.eu/pl/details/rc1206jr-072k/rezystory-smd-1206/yageo/rc1206jr-072kl/#
R4 | 2k | R-EU_R1206 | R1206 | RESISTOR, European symbol | TME | http://www.tme.eu/pl/details/rc1206jr-072k/rezystory-smd-1206/yageo/rc1206jr-072kl/#
R13 | 2k | R-EU_R1206 | R1206 | RESISTOR, European symbol | TME | http://www.tme.eu/pl/details/rc1206jr-072k/rezystory-smd-1206/yageo/rc1206jr-072kl/#
R14 | 2k | R-EU_R1206 | R1206 | RESISTOR, European symbol | TME | http://www.tme.eu/pl/details/rc1206jr-072k/rezystory-smd-1206/yageo/rc1206jr-072kl/#
R15 | 2k | R-EU_R1206 | R1206 | RESISTOR, European symbol | TME | http://www.tme.eu/pl/details/rc1206jr-072k/rezystory-smd-1206/yageo/rc1206jr-072kl/#
R16 | 24k | R-EU_R1206 | R1206 | RESISTOR, European symbol | TME | http://www.tme.eu/pl/details/rc1206jr-0724k/rezystory-smd-1206/yageo/rc1206jr-0724kl/#
R17 | 4k7 | R-EU_R1206 | R1206 | RESISTOR, European symbol | TME | http://www.tme.eu/pl/details/smd1206-4k7/rezystory-smd-1206/royal-ohm/1206s4j0472t5e/#
R18 | 1k | R-EU_R1206 | R1206 | RESISTOR, European symbol | TME | http://www.tme.eu/pl/details/rc1206jr-071k/rezystory-smd-1206/yageo/rc1206jr-071kl/#
R19 | 4k7 | R-EU_R1206 | R1206 | RESISTOR, European symbol | TME | http://www.tme.eu/pl/details/smd1206-4k7/rezystory-smd-1206/royal-ohm/1206s4j0472t5e/#
R20 | 4k7 | R-EU_R1206 | R1206 | RESISTOR, European symbol | TME | http://www.tme.eu/pl/details/smd1206-4k7/rezystory-smd-1206/royal-ohm/1206s4j0472t5e/#
R21 | 1k | R-EU_R1206 | R1206 | RESISTOR, European symbol | TME | http://www.tme.eu/pl/details/rc1206jr-071k/rezystory-smd-1206/yageo/rc1206jr-071kl/#
R22 | 1k | R-EU_R1206 | R1206 | RESISTOR, European symbol | TME | http://www.tme.eu/pl/details/rc1206jr-071k/rezystory-smd-1206/yageo/rc1206jr-071kl/#
R23 | 100k | R-EU_R1206 | R1206 | RESISTOR, European symbol | TME | http://www.tme.eu/pl/details/rc1206jr-07100k/rezystory-smd-1206/yageo/rc1206jr-07100kl/#
R24 | 4k7 | R-EU_R1206 | R1206 | RESISTOR, European symbol | TME | http://www.tme.eu/pl/details/smd1206-4k7/rezystory-smd-1206/royal-ohm/1206s4j0472t5e/#
R25 | 2k | R-EU_R1206 | R1206 | RESISTOR, European symbol | TME | http://www.tme.eu/pl/details/rc1206jr-072k/rezystory-smd-1206/yageo/rc1206jr-072kl/#
R26 | 470R | R-EU_R1206 | R1206 | RESISTOR, European symbol | TME | http://www.tme.eu/pl/details/rc1206jr-07470r/rezystory-smd-1206/yageo/rc1206jr-07470rl/#
R27 | 100k | R-EU_R1206 | R1206 | RESISTOR, European symbol | TME | http://www.tme.eu/pl/details/rc1206jr-07100k/rezystory-smd-1206/yageo/rc1206jr-07100kl/#
R28 | 10M | R-EU_R1206 | R1206 | RESISTOR, European symbol | TME | http://www.tme.eu/pl/details/smd1206-10m/rezystory-smd-1206/royal-ohm/1206s4j-10m-t5e/#
R29 | 4k7 | R-EU_R1206 | R1206 | RESISTOR, European symbol | TME | http://www.tme.eu/pl/details/smd1206-4k7/rezystory-smd-1206/royal-ohm/1206s4j0472t5e/# | http://www.tme.eu/pl/details/smd1206-4k7/rezystory-smd-1206/royal-ohm/1206s4j0472t5e/#
R30 | 4k7 | R-EU_R1206 | R1206 | RESISTOR, European symbol | TME | http://www.tme.eu/pl/details/smd1206-4k7/rezystory-smd-1206/royal-ohm/1206s4j0472t5e/# | http://www.tme.eu/pl/details/smd1206-4k7/rezystory-smd-1206/royal-ohm/1206s4j0472t5e/#
R31 | 4k7 | R-EU_R1206 | R1206 | RESISTOR, European symbol | TME | http://www.tme.eu/pl/details/smd1206-4k7/rezystory-smd-1206/royal-ohm/1206s4j0472t5e/#
R32 | 4k7 | R-EU_R1206 | R1206 | RESISTOR, European symbol | TME | http://www.tme.eu/pl/details/smd1206-4k7/rezystory-smd-1206/royal-ohm/1206s4j0472t5e/#
R33 | 4k7 | R-EU_R1206 | R1206 | RESISTOR, European symbol | TME | http://www.tme.eu/pl/details/smd1206-4k7/rezystory-smd-1206/royal-ohm/1206s4j0472t5e/#
R34 | 4k7 | R-EU_R1206 | R1206 | RESISTOR, European symbol | TME | http://www.tme.eu/pl/details/smd1206-4k7/rezystory-smd-1206/royal-ohm/1206s4j0472t5e/#
R35 | 4k7 | R-EU_R1206 | R1206 | RESISTOR, European symbol | TME | http://www.tme.eu/pl/details/smd1206-4k7/rezystory-smd-1206/royal-ohm/1206s4j0472t5e/#
R36 | 470R | R-EU_R1206 | R1206 | RESISTOR, European symbol | TME | http://www.tme.eu/pl/details/rc1206jr-07470r/rezystory-smd-1206/yageo/rc1206jr-07470rl/#
R38 | 1k | R-EU_R1206 | R1206 | RESISTOR, European symbol | TME | http://www.tme.eu/pl/details/rc1206jr-071k/rezystory-smd-1206/yageo/rc1206jr-071kl/#
SV1 |  | MA04-1 | MA04-1 | PIN HEADER | TME | http://www.tme.eu/pl/details/zl209-40p/listwy-i-gniazda-kolkowe/connfly/ds1021-1_40sf1-5/#
SV2 |  | MA04-1 | MA04-1 | PIN HEADER | TME | http://www.tme.eu/pl/details/zl209-40p/listwy-i-gniazda-kolkowe/connfly/ds1021-1_40sf1-5/#
SV3 |  | MA04-1 | MA04-1 | PIN HEADER | TME | http://www.tme.eu/pl/details/zl209-40p/listwy-i-gniazda-kolkowe/connfly/ds1021-1_40sf1-5/#
T1 | BC817 | BC817-16-NPN-SOT23-BEC | SOT23-BEC | NPN Transistror | TME | http://www.tme.eu/pl/details/bc817-16/tranzystory-npn-smd/#
T2 | BC817 | BC817-16-NPN-SOT23-BEC | SOT23-BEC | NPN Transistror | TME | http://www.tme.eu/pl/details/bc817-16/tranzystory-npn-smd/#
T3 | IRLML2244 | MOSFET-PCHANNELSMD | SOT23-3 | Generic PMOSFET | TME | http://www.tme.eu/pl/details/irlml2244trpbf/tranzystory-z-kanalem-p-smd/international-rectifier/#
T4 | 2N7002PW | MOSFET-NCHANNELSOT323 | SOT323 | Generic NMOS footprint | Mouser | http://pl.mouser.com/ProductDetail/NXP/2N7002PW115/
U1 | P82B715 | P82B715_I2C_BUS_EXTENDER | SO-08 |  | TME | http://www.tme.eu/pl/details/p82b715td/mikrokontrolery-nxp-8051/nxp/p82b715td112/#
U2 | P82B715 | P82B715_I2C_BUS_EXTENDER | SO-08 |  | TME | http://www.tme.eu/pl/details/p82b715td/mikrokontrolery-nxp-8051/nxp/p82b715td112/#
U3 | P82B715 | P82B715_I2C_BUS_EXTENDER | SO-08 |  | TME | http://www.tme.eu/pl/details/p82b715td/mikrokontrolery-nxp-8051/nxp/p82b715td112/#
U4 | VREG_MIC5216 | VREG_MIC5216 | MSOP8 | 500mA LDO, MSOP8 for better dissipation | Mouser | http://pl.mouser.com/ProductDetail/Micrel/MIC5216-33YMM/
U5 | TPS62133RGTT | TPS6214X | QFN16-3X3MM | 3-17V, 2A Step Down Converter | Mouser | http://pl.mouser.com/ProductDetail/Texas-Instruments/TPS62133RGTT/
U7 | PIC24FJ256GB206 | PIC24FXXXDAX06 | PIC24FXXX_TQFP64 | PIC24FXXXDAX06 | Mouser | http://pl.mouser.com/ProductDetail/Microchip-Technology/PIC24FJ256GB206-I-PT/
U8 | LMC555 | LMC555 | SO08 | General purpose Timer | TME | http://www.tme.eu/pl/details/lmc555cm_nopb/uklady-watchdog-i-reset/texas-instruments/#

Sheet: Main board v1.3.xls]Anemometer
Part | Value | Device | Package | Description | Vendors | Link1
C1 | 10u | C-EUC1206 | C1206 | CAPACITOR, European symbol | TME | http://www.tme.eu/pl/details/c1206c106k4rac/kondensatory-mlcc-smd-1206/kemet/#
C5 | 100uF/25V | CPOL-EUE2-5 | E2-5 | POLARIZED CAPACITOR, European symbol | TME | http://www.tme.eu/pl/details/sd1e107m05011pc/kondensatory-85c/samwha/#
C6 | 100n | C-EUC1206 | C1206 | CAPACITOR, European symbol | TME | http://www.tme.eu/pl/details/cl31b104kbcnnnc/kondensatory-mlcc-smd-1206/samsung/#
C7 | 100p | C-EUC1206 | C1206 | CAPACITOR, European symbol | TME | http://www.tme.eu/pl/details/cl31c101jbcnnnc/kondensatory-mlcc-smd-1206/samsung/#
C11 | 10uF | C-EUC1206 | C1206 | CAPACITOR, European symbol | TME | http://www.tme.eu/pl/details/c1206c106k4rac/kondensatory-mlcc-smd-1206/kemet/#
C12 | 3n3 | C-EUC1206 | C1206 | CAPACITOR, European symbol | TME | http://www.tme.eu/pl/details/12065c332kat2a/kondensatory-mlcc-smd-1206/avx/#
C13 | 10uF | C-EUC1206 | C1206 | CAPACITOR, European symbol | TME | http://www.tme.eu/pl/details/c1206c106k4rac/kondensatory-mlcc-smd-1206/kemet/#
C16 | 10uF | C-EUC1206 | C1206 | CAPACITOR, European symbol | TME | http://www.tme.eu/pl/details/c1206c106k4rac/kondensatory-mlcc-smd-1206/kemet/#
C17 | 100uF/10V/tantal_B | CPOL-EUB/3528-21R | B/3528-21R | POLARIZED CAPACITOR, European symbol | TME | http://www.tme.eu/pl/details/tajb107m010r/kondensatory-tantalowe-smd/avx/tajb107m010rnj/#
C18 | 100n | C-EUC1206 | C1206 | CAPACITOR, European symbol | TME | http://www.tme.eu/pl/details/cl31b104kbcnnnc/kondensatory-mlcc-smd-1206/samsung/#
C19 | 10n | C-EUC1206 | C1206 | CAPACITOR, European symbol | TME | http://www.tme.eu/pl/details/cl31b103kbcnnnc/kondensatory-mlcc-smd-1206/samsung/#
C20 | 100n | C-EUC1206 | C1206 | CAPACITOR, European symbol | TME | http://www.tme.eu/pl/details/cl31b104kbcnnnc/kondensatory-mlcc-smd-1206/samsung/#
C21 | 100n | C-EUC1206 | C1206 | CAPACITOR, European symbol | TME | http://www.tme.eu/pl/details/cl31b104kbcnnnc/kondensatory-mlcc-smd-1206/samsung/#
C22 | 100n | C-EUC1206 | C1206 | CAPACITOR, European symbol | TME | http://www.tme.eu/pl/details/cl31b104kbcnnnc/kondensatory-mlcc-smd-1206/samsung/#
C23 | 100n | C-EUC1206 | C1206 | CAPACITOR, European symbol | TME | http://www.tme.eu/pl/details/cl31b104kbcnnnc/kondensatory-mlcc-smd-1206/samsung/#
C24 | 10uF | C-EUC1206 | C1206 | CAPACITOR, European symbol | TME | http://www.tme.eu/pl/details/c1206c106k4rac/kondensatory-mlcc-smd-1206/kemet/#
C25 | 100n | C-EUC1206 | C1206 | CAPACITOR, European symbol | TME | http://www.tme.eu/pl/details/cl31b104kbcnnnc/kondensatory-mlcc-smd-1206/samsung/#
D1 | 1N4004 | 1N4004 | DO41-10 | DIODE | TME | http://www.tme.eu/pl/details/1n4004/diody-uniwersalne-tht/dc-components/#
D3 | SS14 | DIODE-SCHOTTKY_ | SMA-DIODE | Commonly MBRA140. | TME | http://www.tme.eu/pl/details/ss14/diody-schottky-smd/dc-components/#
F2 |  | FUSE_HOLDER | ZHL30 |  | TME | http://www.tme.eu/pl/details/zhl30/bezpieczniki-gniazda-pcb/#t735977d29e6b3d766657895563ce61ae
F3 | PTCSMD | PTCSMD | PTC-1206 | Resettable Fuse PTC | TME | http://www.tme.eu/pl/details/sn075-06/bezpieczniki-polimerowe-smd/ece/#
J2 | RJ11MX-95001-2661 | RJ11MX-95001-2661 | MX-95001-2661 | CORCOM Modular RJ Jacks No Shield | ELFA | https://www.elfa.se/elfa3~se_sv/elfa/init.do?item=42-696-27&toc=0&q=42-696-27
J3 | POWER_JACKPTH | POWER_JACKPTH | PC-GK2.1 | Power Jack | TME | http://www.tme.eu/pl/details/pc-gk2.1/zlacza-dc/#
J7 | 10104111-0001LF | USB_AB | USB-AB-MICRO-SMD | This is a USB AB connector that is compatible with USB OTG. | Mouser | http://pl.mouser.com/ProductDetail/FCI/10104111-0001LF/
JP3 |  | JUMPER-2PTH | 1X02 | Jumper | TME | http://www.tme.eu/pl/details/zl209-40p/listwy-i-gniazda-kolkowe/connfly/ds1021-1_40sf1-5/#
JP4 |  | MA06-1 | MA06-1 | PIN HEADER | TME | http://www.tme.eu/pl/details/zl209-40p/listwy-i-gniazda-kolkowe/connfly/ds1021-1_40sf1-5/#
JP5 |  | JUMPER-2PTH | 1X02 | Jumper | TME | http://www.tme.eu/pl/details/zl209-40p/listwy-i-gniazda-kolkowe/connfly/ds1021-1_40sf1-5/#
L1 | VLC5045T-3R3N, 3.3uH | INDUCTORCR54 | CR54 | Inductors | Mouser | http://pl.mouser.com/ProductDetail/TDK/VLC5045T-3R3N/
L2 | 30Ohm ,3A | L-US | R1206 | INDUCTOR, American symbol | Mouser | http://pl.mouser.com/ProductDetail/Fair-Rite/2512063007Y0/
LED1 | LS L29K-G1J2-1-Z | LED1206 | LED-1206 | LEDs | TME | http://www.tme.eu/pl/details/osr51206c1c/diody-led-smd-1206/optosupply/#
LED2 | LY L29K-J1K2-26-Z | LED1206 | LED-1206 | LEDs | TME | http://www.tme.eu/pl/details/osr51206c1c/diody-led-smd-1206/optosupply/#
R1 | 2k | R-EU_R1206 | R1206 | RESISTOR, European symbol | TME | http://www.tme.eu/pl/details/rc1206jr-072k/rezystory-smd-1206/yageo/rc1206jr-072kl/#
R5 | 470R | R-EU_R1206 | R1206 | RESISTOR, European symbol | TME | http://www.tme.eu/pl/details/rc1206jr-07470r/rezystory-smd-1206/yageo/rc1206jr-07470rl/#
R12 | 470R | R-EU_R1206 | R1206 | RESISTOR, European symbol | TME | http://www.tme.eu/pl/details/rc1206jr-07470r/rezystory-smd-1206/yageo/rc1206jr-07470rl/#
R16 | 24k | R-EU_R1206 | R1206 | RESISTOR, European symbol | TME | http://www.tme.eu/pl/details/rc1206jr-0724k/rezystory-smd-1206/yageo/rc1206jr-0724kl/#
R17 | 4k7 | R-EU_R1206 | R1206 | RESISTOR, European symbol | TME | http://www.tme.eu/pl/details/smd1206-4k7/rezystory-smd-1206/royal-ohm/1206s4j0472t5e/#
R20 | 4k7 | R-EU_R1206 | R1206 | RESISTOR, European symbol | TME | http://www.tme.eu/pl/details/smd1206-4k7/rezystory-smd-1206/royal-ohm/1206s4j0472t5e/#
R21 | 1k | R-EU_R1206 | R1206 | RESISTOR, European symbol | TME | http://www.tme.eu/pl/details/rc1206jr-071k/rezystory-smd-1206/yageo/rc1206jr-071kl/#
R23 | 100k | R-EU_R1206 | R1206 | RESISTOR, European symbol | TME | http://www.tme.eu/pl/details/rc1206jr-07100k/rezystory-smd-1206/yageo/rc1206jr-07100kl/#
R25 | 2k | R-EU_R1206 | R1206 | RESISTOR, European symbol | TME | http://www.tme.eu/pl/details/rc1206jr-072k/rezystory-smd-1206/yageo/rc1206jr-072kl/#
R26 | 470R | R-EU_R1206 | R1206 | RESISTOR, European symbol | TME | http://www.tme.eu/pl/details/rc1206jr-07470r/rezystory-smd-1206/yageo/rc1206jr-07470rl/#
R27 | 100k | R-EU_R1206 | R1206 | RESISTOR, European symbol | TME | http://www.tme.eu/pl/details/rc1206jr-07100k/rezystory-smd-1206/yageo/rc1206jr-07100kl/#
R28 | 10M | R-EU_R1206 | R1206 | RESISTOR, European symbol | TME | http://www.tme.eu/pl/details/smd1206-10m/rezystory-smd-1206/royal-ohm/1206s4j-10m-t5e/#
R35 | 4k7 | R-EU_R1206 | R1206 | RESISTOR, European symbol | TME | http://www.tme.eu/pl/details/smd1206-4k7/rezystory-smd-1206/royal-ohm/1206s4j0472t5e/#
R36 | 470R | R-EU_R1206 | R1206 | RESISTOR, European symbol | TME | http://www.tme.eu/pl/details/rc1206jr-07470r/rezystory-smd-1206/yageo/rc1206jr-07470rl/#
R38 | 1k | R-EU_R1206 | R1206 | RESISTOR, European symbol | TME | http://www.tme.eu/pl/details/rc1206jr-071k/rezystory-smd-1206/yageo/rc1206jr-071kl/#
T3 | IRLML2244 | MOSFET-PCHANNELSMD | SOT23-3 | Generic PMOSFET | TME | http://www.tme.eu/pl/details/irlml2244trpbf/tranzystory-z-kanalem-p-smd/international-rectifier/#
T4 | 2N7002PW | MOSFET-NCHANNELSOT323 | SOT323 | Generic NMOS footprint | Mouser | http://pl.mouser.com/ProductDetail/NXP/2N7002PW115/
U4 | VREG_MIC5216 | VREG_MIC5216 | MSOP8 | 500mA LDO, MSOP8 for better dissipation | Mouser | http://pl.mouser.com/ProductDetail/Micrel/MIC5216-33YMM/
U5 | TPS62133RGTT | TPS6214X | QFN16-3X3MM | 3-17V, 2A Step Down Converter | Mouser | http://pl.mouser.com/ProductDetail/Texas-Instruments/TPS62133RGTT/
U7 | PIC24FJ256GB206 | PIC24FXXXDAX06 | PIC24FXXX_TQFP64 | PIC24FXXXDAX06 | Mouser | http://pl.mouser.com/ProductDetail/Microchip-Technology/PIC24FJ256GB206-I-PT/
U8 | LMC555 | LMC555 | SO08 | General purpose Timer | TME | http://www.tme.eu/pl/details/lmc555cm_nopb/uklady-watchdog-i-reset/texas-instruments/#

Sheet: Main board v1.3.xls]Humidity_sensor
Part | Value | Device | Package | Description | Vendors | Link1
C5 | 100uF/25V | CPOL-EUE2-5 | E2-5 | POLARIZED CAPACITOR, European symbol | TME | http://www.tme.eu/pl/details/sd1e107m05011pc/kondensatory-85c/samwha/#
C11 | 10uF | C-EUC1206 | C1206 | CAPACITOR, European symbol | TME | http://www.tme.eu/pl/details/c1206c106k4rac/kondensatory-mlcc-smd-1206/kemet/#
C12 | 3n3 | C-EUC1206 | C1206 | CAPACITOR, European symbol | TME | http://www.tme.eu/pl/details/12065c332kat2a/kondensatory-mlcc-smd-1206/avx/#
C13 | 10uF | C-EUC1206 | C1206 | CAPACITOR, European symbol | TME | http://www.tme.eu/pl/details/c1206c106k4rac/kondensatory-mlcc-smd-1206/kemet/#
C14 | 100n | C-EUC1206 | C1206 | CAPACITOR, European symbol | TME | http://www.tme.eu/pl/details/cl31b104kbcnnnc/kondensatory-mlcc-smd-1206/samsung/#
C15 | 220n | C-EUC1206 | C1206 | CAPACITOR, European symbol | TME | http://www.tme.eu/pl/details/cl31b224kbfnnne/kondensatory-mlcc-smd-1206/samsung/#
C16 | 10uF | C-EUC1206 | C1206 | CAPACITOR, European symbol | TME | http://www.tme.eu/pl/details/c1206c106k4rac/kondensatory-mlcc-smd-1206/kemet/#
C17 | 100uF/10V/tantal_B | CPOL-EUB/3528-21R | B/3528-21R | POLARIZED CAPACITOR, European symbol | TME | http://www.tme.eu/pl/details/tajb107m010r/kondensatory-tantalowe-smd/avx/tajb107m010rnj/#
C18 | 100n | C-EUC1206 | C1206 | CAPACITOR, European symbol | TME | http://www.tme.eu/pl/details/cl31b104kbcnnnc/kondensatory-mlcc-smd-1206/samsung/#
C19 | 10n | C-EUC1206 | C1206 | CAPACITOR, European symbol | TME | http://www.tme.eu/pl/details/cl31b103kbcnnnc/kondensatory-mlcc-smd-1206/samsung/#
C20 | 100n | C-EUC1206 | C1206 | CAPACITOR, European symbol | TME | http://www.tme.eu/pl/details/cl31b104kbcnnnc/kondensatory-mlcc-smd-1206/samsung/#
C21 | 100n | C-EUC1206 | C1206 | CAPACITOR, European symbol | TME | http://www.tme.eu/pl/details/cl31b104kbcnnnc/kondensatory-mlcc-smd-1206/samsung/#
C22 | 100n | C-EUC1206 | C1206 | CAPACITOR, European symbol | TME | http://www.tme.eu/pl/details/cl31b104kbcnnnc/kondensatory-mlcc-smd-1206/samsung/#
C23 | 100n | C-EUC1206 | C1206 | CAPACITOR, European symbol | TME | http://www.tme.eu/pl/details/cl31b104kbcnnnc/kondensatory-mlcc-smd-1206/samsung/#
C24 | 10uF | C-EUC1206 | C1206 | CAPACITOR, European symbol | TME | http://www.tme.eu/pl/details/c1206c106k4rac/kondensatory-mlcc-smd-1206/kemet/#
C25 | 100n | C-EUC1206 | C1206 | CAPACITOR, European symbol | TME | http://www.tme.eu/pl/details/cl31b104kbcnnnc/kondensatory-mlcc-smd-1206/samsung/#
D1 | 1N4004 | 1N4004 | DO41-10 | DIODE | TME | http://www.tme.eu/pl/details/1n4004/diody-uniwersalne-tht/dc-components/#
D3 | SS14 | DIODE-SCHOTTKY_ | SMA-DIODE | Commonly MBRA140. | TME | http://www.tme.eu/pl/details/ss14/diody-schottky-smd/dc-components/#
F2 |  | FUSE_HOLDER | ZHL30 |  | TME | http://www.tme.eu/pl/details/zhl30/bezpieczniki-gniazda-pcb/#t735977d29e6b3d766657895563ce61ae
F3 | PTCSMD | PTCSMD | PTC-1206 | Resettable Fuse PTC | TME | http://www.tme.eu/pl/details/sn075-06/bezpieczniki-polimerowe-smd/ece/#
J3 | POWER_JACKPTH | POWER_JACKPTH | PC-GK2.1 | Power Jack | TME | http://www.tme.eu/pl/details/pc-gk2.1/zlacza-dc/#
J7 | 10104111-0001LF | USB_AB | USB-AB-MICRO-SMD | This is a USB AB connector that is compatible with USB OTG. | Mouser | http://pl.mouser.com/ProductDetail/FCI/10104111-0001LF/
JP3 |  | JUMPER-2PTH | 1X02 | Jumper | TME | http://www.tme.eu/pl/details/zl209-40p/listwy-i-gniazda-kolkowe/connfly/ds1021-1_40sf1-5/#
JP4 |  | MA06-1 | MA06-1 | PIN HEADER | TME | http://www.tme.eu/pl/details/zl209-40p/listwy-i-gniazda-kolkowe/connfly/ds1021-1_40sf1-5/#
JP5 |  | JUMPER-2PTH | 1X02 | Jumper | TME | http://www.tme.eu/pl/details/zl209-40p/listwy-i-gniazda-kolkowe/connfly/ds1021-1_40sf1-5/#
L1 | VLC5045T-3R3N, 3.3uH | INDUCTORCR54 | CR54 | Inductors | Mouser | http://pl.mouser.com/ProductDetail/TDK/VLC5045T-3R3N/
L2 | 30Ohm ,3A | L-US | R1206 | INDUCTOR, American symbol | Mouser | http://pl.mouser.com/ProductDetail/Fair-Rite/2512063007Y0/
LED1 | LS L29K-G1J2-1-Z | LED1206 | LED-1206 | LEDs | TME | http://www.tme.eu/pl/details/osr51206c1c/diody-led-smd-1206/optosupply/#
LED2 | LY L29K-J1K2-26-Z | LED1206 | LED-1206 | LEDs | TME | http://www.tme.eu/pl/details/osr51206c1c/diody-led-smd-1206/optosupply/#
R16 | 24k | R-EU_R1206 | R1206 | RESISTOR, European symbol | TME | http://www.tme.eu/pl/details/rc1206jr-0724k/rezystory-smd-1206/yageo/rc1206jr-0724kl/#
R17 | 4k7 | R-EU_R1206 | R1206 | RESISTOR, European symbol | TME | http://www.tme.eu/pl/details/smd1206-4k7/rezystory-smd-1206/royal-ohm/1206s4j0472t5e/#
R20 | 4k7 | R-EU_R1206 | R1206 | RESISTOR, European symbol | TME | http://www.tme.eu/pl/details/smd1206-4k7/rezystory-smd-1206/royal-ohm/1206s4j0472t5e/#
R21 | 1k | R-EU_R1206 | R1206 | RESISTOR, European symbol | TME | http://www.tme.eu/pl/details/rc1206jr-071k/rezystory-smd-1206/yageo/rc1206jr-071kl/#
R23 | 100k | R-EU_R1206 | R1206 | RESISTOR, European symbol | TME | http://www.tme.eu/pl/details/rc1206jr-07100k/rezystory-smd-1206/yageo/rc1206jr-07100kl/#
R25 | 2k | R-EU_R1206 | R1206 | RESISTOR, European symbol | TME | http://www.tme.eu/pl/details/rc1206jr-072k/rezystory-smd-1206/yageo/rc1206jr-072kl/#
R26 | 470R | R-EU_R1206 | R1206 | RESISTOR, European symbol | TME | http://www.tme.eu/pl/details/rc1206jr-07470r/rezystory-smd-1206/yageo/rc1206jr-07470rl/#
R27 | 100k | R-EU_R1206 | R1206 | RESISTOR, European symbol | TME | http://www.tme.eu/pl/details/rc1206jr-07100k/rezystory-smd-1206/yageo/rc1206jr-07100kl/#
R28 | 10M | R-EU_R1206 | R1206 | RESISTOR, European symbol | TME | http://www.tme.eu/pl/details/smd1206-10m/rezystory-smd-1206/royal-ohm/1206s4j-10m-t5e/#
R29 | 4k7 | R-EU_R1206 | R1206 | RESISTOR, European symbol | TME | http://www.tme.eu/pl/details/smd1206-4k7/rezystory-smd-1206/royal-ohm/1206s4j0472t5e/# | http://www.tme.eu/pl/details/smd1206-4k7/rezystory-smd-1206/royal-ohm/1206s4j0472t5e/#
R32 | 4k7 | R-EU_R1206 | R1206 | RESISTOR, European symbol | TME | http://www.tme.eu/pl/details/smd1206-4k7/rezystory-smd-1206/royal-ohm/1206s4j0472t5e/#
R35 | 4k7 | R-EU_R1206 | R1206 | RESISTOR, European symbol | TME | http://www.tme.eu/pl/details/smd1206-4k7/rezystory-smd-1206/royal-ohm/1206s4j0472t5e/#
R36 | 470R | R-EU_R1206 | R1206 | RESISTOR, European symbol | TME | http://www.tme.eu/pl/details/rc1206jr-07470r/rezystory-smd-1206/yageo/rc1206jr-07470rl/#
R38 | 1k | R-EU_R1206 | R1206 | RESISTOR, European symbol | TME | http://www.tme.eu/pl/details/rc1206jr-071k/rezystory-smd-1206/yageo/rc1206jr-071kl/#
T3 | IRLML2244 | MOSFET-PCHANNELSMD | SOT23-3 | Generic PMOSFET | TME | http://www.tme.eu/pl/details/irlml2244trpbf/tranzystory-z-kanalem-p-smd/international-rectifier/#
T4 | 2N7002PW | MOSFET-NCHANNELSOT323 | SOT323 | Generic NMOS footprint | Mouser | http://pl.mouser.com/ProductDetail/NXP/2N7002PW115/
U4 | VREG_MIC5216 | VREG_MIC5216 | MSOP8 | 500mA LDO, MSOP8 for better dissipation | Mouser | http://pl.mouser.com/ProductDetail/Micrel/MIC5216-33YMM/
U5 | TPS62133RGTT | TPS6214X | QFN16-3X3MM | 3-17V, 2A Step Down Converter | Mouser | http://pl.mouser.com/ProductDetail/Texas-Instruments/TPS62133RGTT/
U6 | CC2D23-CHIPCAP2 | CC2D23-CHIPCAP2 | CC2D23-CHIPCAP2 |  | Mouser | http://pl.mouser.com/ProductDetail/GE-MC-NovaSensor/CC2D23/
U7 | PIC24FJ256GB206 | PIC24FXXXDAX06 | PIC24FXXX_TQFP64 | PIC24FXXXDAX06 | Mouser | http://pl.mouser.com/ProductDetail/Microchip-Technology/PIC24FJ256GB206-I-PT/
U8 | LMC555 | LMC555 | SO08 | General purpose Timer | TME | http://www.tme.eu/pl/details/lmc555cm_nopb/uklady-watchdog-i-reset/texas-instruments/#
