edarn/kryp-client/Web/SurfVind_web/Surfvind/Documents/WindMaster - Installationsanvisning v2.pdf

### Installationsmanual – WindMaster

Vi hoppas du kommer bli nöjd med din nya WindMaster, och för att försäkra oss om det vill vi här guida dig genom installationen av denna produkt.

1. Börja med att packa upp det vita paketet märkt ”Davis” som innehåller vindsensorn. Montera mätaren enligt sida 1-5 i den manual som medföljer i detta paket. Bortse från sida 6 och framåt, då dessa sidor kräver att man kopplar vindsensorn till en helt annan apparat. Var noga med att följa anvisningarna så att inte sensorn påverkas negativt.
2. Packa sedan upp Cinterion modemet i den gråa boxen och stoppa i ett SIM kort från någon av de svenska tele-operatörerna (Telia, Tele2, Vodafone, Comviq). Isättningen av SIM kortet sker genom att man tar ett gem eller liknande och trycker in den gula knappen för att få ut SIM-korts hållaren. OBS, se till att SIM kortet INTE har någon PIN kod aktiverad. Avstängning av PIN koden görs lättast genom att stoppa in det i en mobiltelefon och där stänga av det.

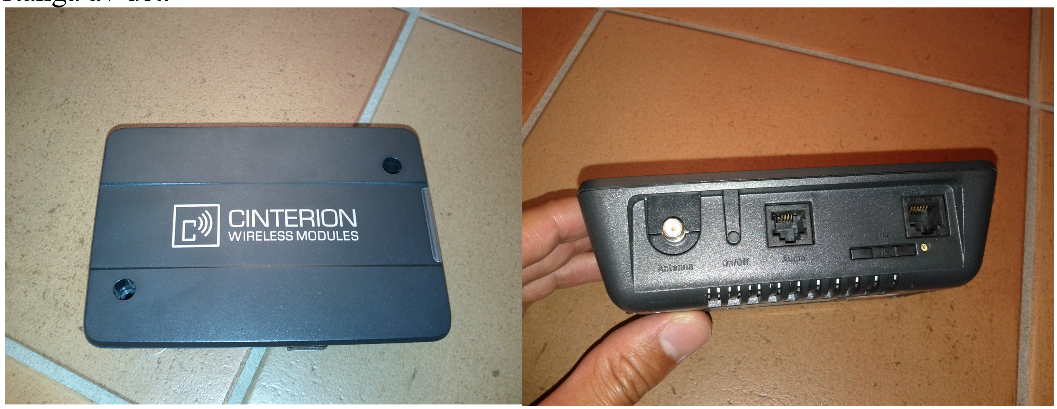
[picture p69: figure]

3. Skruva på antennen. Den medföljande stora antennen är optimerad för att att mätaren ska dra så lite ström som möjligt. Anses den för skrymmande går det bra att byta ut den mot en mindre GSM antenn.
4. Koppla ihop vindmätaren med den medföljande kabeln.

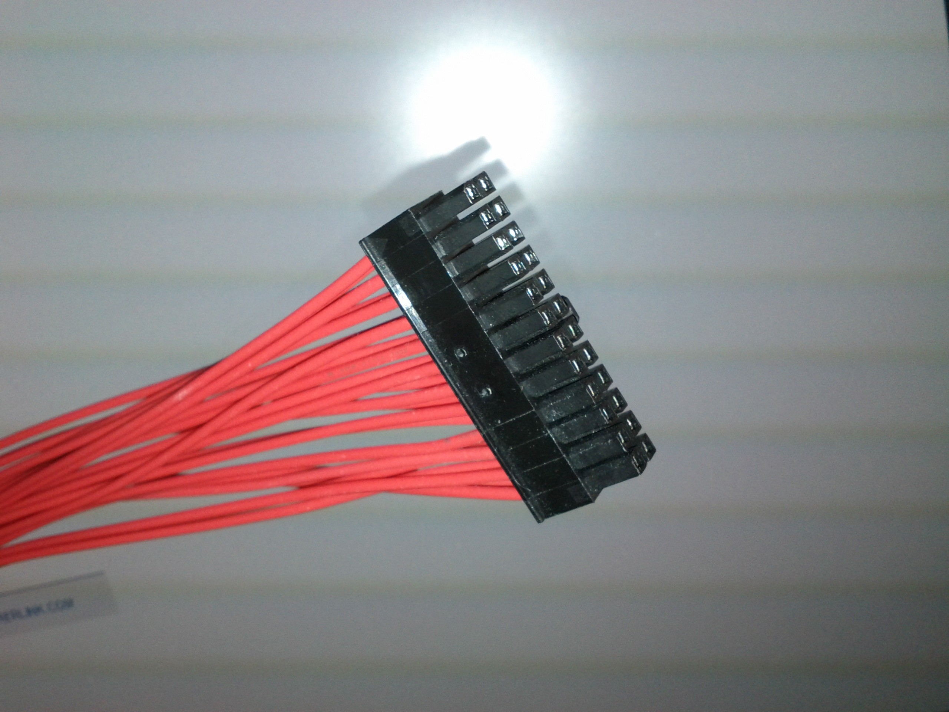
[picture p70: figure]

5. Koppla i mätaren och starta upp utan att ha vindflöjen (den som visar vindriktningen) monterad. Vänta 3-4 minuter och kontrollera på www.surfvind.se vilken vindriktning er mätare visar.
6. Vrid sedan på metallhuvudet tills www.surfvind.se visar att mätaren pekar mot norr.

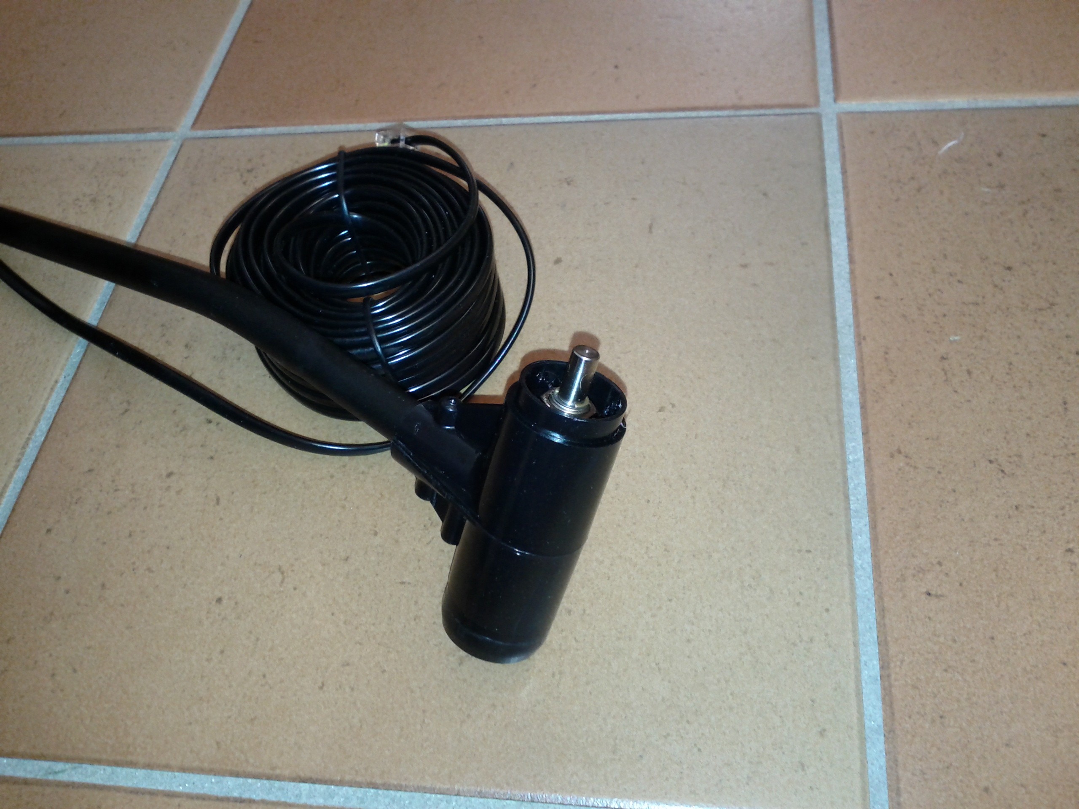
[picture p71: figure]

7. Montera därefter vindflöjen så att den pekar mot norr. Var noga med att inte rotera metallhuvudet innan vindflöjen är ordentligt påskruvad.
8. Kontrollera med en kompass att när mätaren pekar åt norr så visar www.surfvind.se norr, och när ni vrider den mot Väst så stämmer även detta med på webbsidan. Tänk dock på att det tar 2-4 minuter mellan varje uppdatering på sidan innan resultatet visas. Om det inte stämmer så börja om på steg 3.
9. Skicka gps kordinater, adress eller en beskrivning till thomas@tna.se som beskriver var vindmätaren är placerad så vi kan uppdatera webbsidan med google maps över er mätare.
10. Njut av att du nu alltid kommer veta hur mycket det blåser på den aktuella positionen, oavsett var du befinner dig i världen.
