edarn/kryp-client/Web/SurfVind_web/Surfvind/Applet/test.png

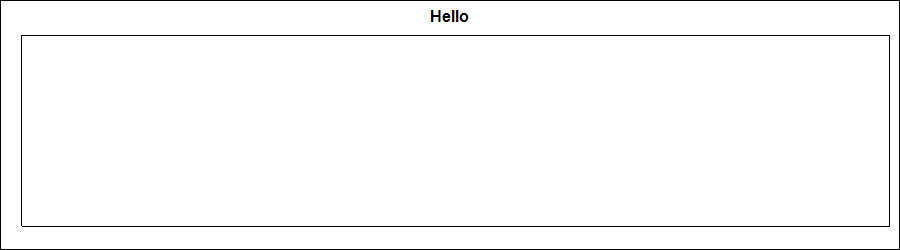
Web/SurfVind_web/Surfvind/Applet/test.png
