edarn/kryp-client/PCB/main_board_1_3 with gerbers/[B]Main board v1.3.brd

## EAGLE design PCB/main_board_1_3 with gerbers/[B]Main board v1.3.brd (2015-01-28)

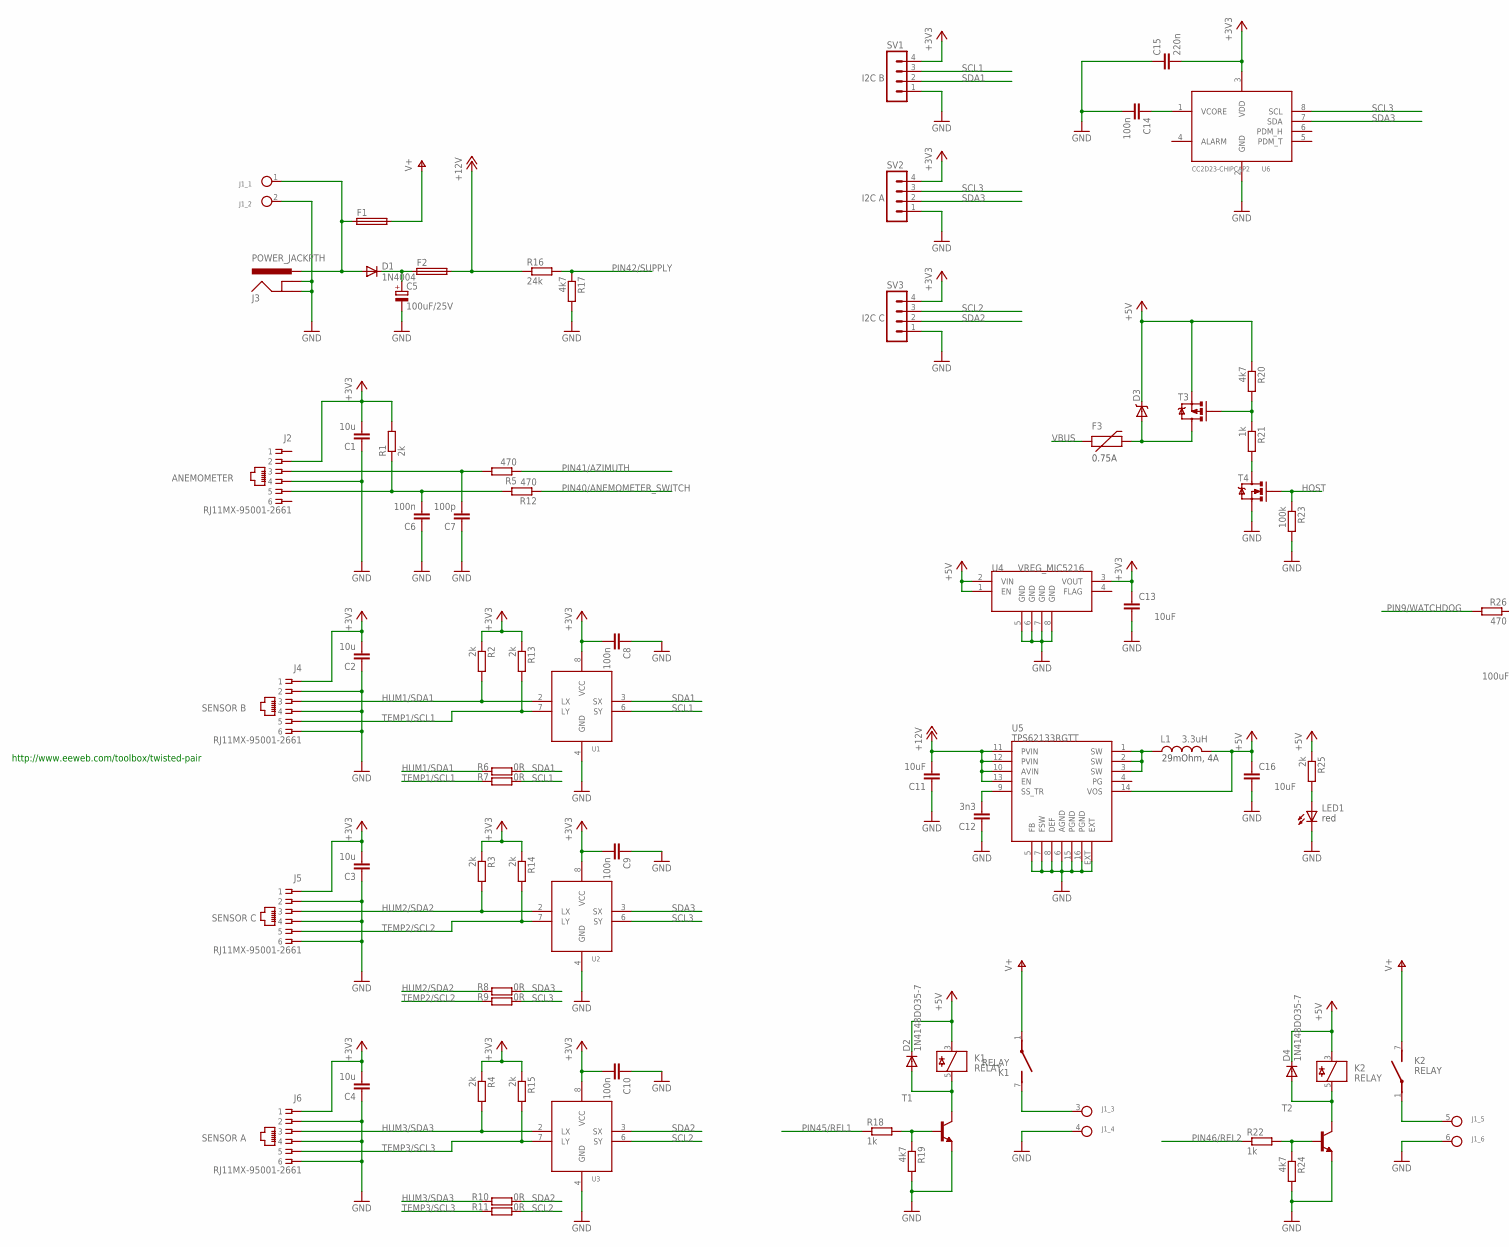
[picture p73: schematic [B]Main board v1.3.sch, part in row 1, column 1]

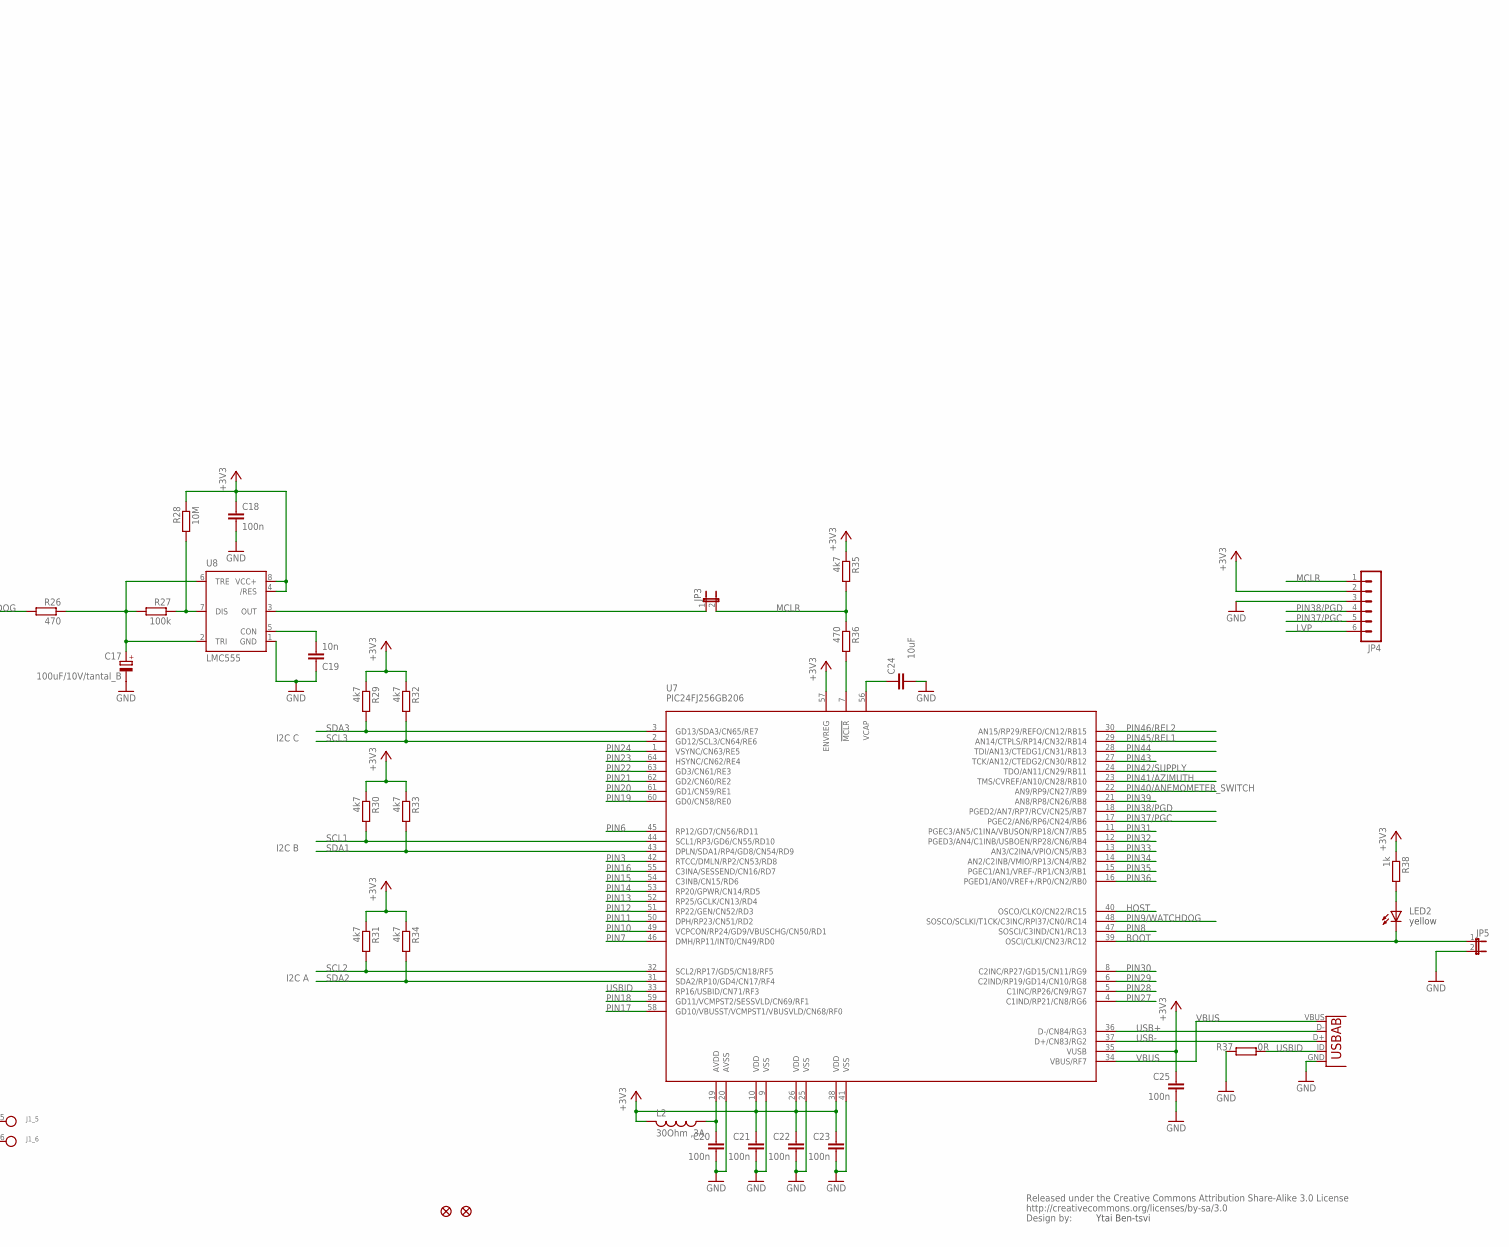
[picture p74: schematic [B]Main board v1.3.sch, part in row 1, column 2]

Parts:
C1, C2, C3, C4: 10u; C1206
C5: 100uF/25V; E2-5
C6, C8, C9, C10, C14, C18, C20, C21, C22, C23, C25: 100n; C1206
C7: 100p; C1206
C11, C13, C16, C24: 10uF; C1206
C12: 3n3; C1206
C15: 220n; C1206
C17: 100uF/10V/tantal_B; B/3528-21R
C19: 10n; C1206
D1: 1N4004; DO41-10
D2, D4: 1N4148DO35-7; DO35-7
D3: B340A; SMA-DIODE; PART# B340A
F1, F2: FUSE_HOLDER; ZHL30
F3: PTCSMD; PTC-1206; PART# 0ZCA0075FF2G
J1: 6P_CONN; MOLEX_39543-0006
J2, J4, J5, J6: RJ11MX-95001-2661; MX-95001-2661
J3: POWER_JACKPTH; PC-GK2.1
J7: 10104111-0001LF; USB-AB-MICRO-SMD
JP1, JP2: FIDUCIALUFIDUCIAL; MICRO-FIDUCIAL
JP3, JP5: JUMPER-2PTH; 1X02
JP4: MA06-1
K1, K2: RELAY; JV-5S-KT
L1: VLC5045T-3R3N; CR54
L2: 30Ohm ,3A; R1206
LED1: LS L29K-G1J2-1-Z; LED-1206
LED2: LY L29K-J1K2-26-Z; LED-1206
R1, R2, R3, R4, R13, R14, R15, R25: 2k; R1206
R5, R12, R26, R36: 470; R1206
R6, R7, R8, R9, R10, R11, R37: 0R; R1206
R16: 24k; R1206
R17, R19, R20, R24, R29, R30, R31, R32, R33, R34, R35: 4k7; R1206
R18, R21, R22, R38: 1k; R1206
R23, R27: 100k; R1206
R28: 10M; R1206
SV1, SV2, SV3: MA04-1
T1, T2: BC817-16-NPN-SOT23-BEC; SOT23-BEC
T3: IRLML2244; SOT23-3
T4: 2N7002PW; SOT323; PART# 2N7002PW
U1, U2, U3: P82B715_I2C_BUS_EXTENDER; SO-08
U4: VREG_MIC5216; MSOP8
U5: TPS62133RGTT; QFN16-3X3MM
U6: CC2D23-CHIPCAP2
U7: PIC24FJ256GB206; PIC24FXXX_TQFP64
U8: LMC555; SO08
U$1: CREATIVE_COMMONS

Connections:
+3V3: C1.2, C2.2, C3.2, C4.2, C8.2, C9.2, C10.2, C13.2, C15.2, C18.1, C21.1, C22.1, C23.1, C25.1, J2.2, J4.1, J5.1, J6.1, JP4.2, L2.2, R1.2, R2.1, R3.1, R4.1, R13.1, R14.1, R15.1, R28.1, R29.1, R30.1, R31.1, R32.1, R33.1, R34.1, R35.1, R38.1, SV1.4, SV2.4, SV3.4, U1.8 (VCC), U2.8 (VCC), U3.8 (VCC), U4.3 (VOUT), U6.3 (VDD), U7.10 (VDD), U7.26 (VDD), U7.35 (VUSB), U7.38 (VDD), U7.57 (ENVREG), U8.4 (/RES), U8.8 (VCC+)
+5V: C16.2, D2.C, D3.C, D4.C, K1.3, K2.3, L1.P$2 (2), R20.1, R25.1, T3.2 (S), U4.1 (EN), U4.2 (VIN), U5.14 (VOS)
+12V: C11.2, F2.2, R16.1, U5.10 (AVIN), U5.11 (PVIN), U5.12 (PVIN), U5.13 (EN)
BOOT: JP5.1, LED2.C, U7.39 (OSCI/CLKI/CN23/RC12)
GND: C1.1, C2.1, C3.1, C4.1, C5.-, C6.1, C7.1, C8.1, C9.1, C10.1, C11.1, C12.1, C13.1, C14.2, C15.1, C16.1, C17.-, C18.2, C19.1, C20.2, C21.2, C22.2, C23.2, C24.1, C25.2, J1.2, J1.4, J1.6, J2.4, J3.GND, J3.GNDBREAK, J4.2, J4.4, J4.6, J5.2, J5.4, J5.6, J6.2, J6.4, J6.6, J7.GND, JP4.3, JP5.2, LED1.C, R17.2, R19.2, R23.2, R24.2, R37.2, SV1.1, SV2.1, SV3.1, T1.E, T2.E, T4.2 (S), U1.4 (GND), U2.4 (GND), U3.4 (GND), U4.5 (GND), U4.6 (GND), U4.7 (GND), U4.8 (GND), U5.5 (FB), U5.6 (AGND), U5.7 (FSW), U5.8 (DEF), U5.15 (PGND), U5.16 (PGND), U5.EXT, U6.2 (GND), U7.9 (VSS), U7.20 (AVSS), U7.25 (VSS), U7.41 (VSS), U8.1 (GND)
HOST: R23.1, T4.1 (G), U7.40 (OSCO/CLKO/CN22/RC15)
HUM1/SDA1: J4.3, R2.2, R6.2, U1.2 (LX)
HUM2/SDA2: J5.3, R3.2, R8.2, U2.2 (LX)
HUM3/SDA3: J6.3, R4.2, R10.2, U3.2 (LX)
LVP: JP4.6
MCLR: JP3.2, JP4.1, R35.2, R36.1
unnamed: D1.A, F1.1, J1.1, J3.PWR
unnamed: C6.2, J2.5, R1.1, R12.2
unnamed: C5.+, D1.C, F2.1
unnamed: C7.2, J2.3, R5.2
unnamed: C14.1, U6.1 (VCORE)
unnamed: R36.2, U7.7 (!MCLR)
unnamed: JP3.1, U8.3 (OUT)
unnamed: R18.2, R19.1, T1.B
unnamed: D2.A, K1.5, T1.C
unnamed: C19.2, U8.5 (CON)
unnamed: J1.3, K1.7 (S)
unnamed: C17.+, R26.1, R27.2, U8.2 (TRI), U8.6 (TRE)
unnamed: R27.1, R28.2, U8.7 (DIS)
unnamed: R22.2, R24.1, T2.B
unnamed: D4.A, K2.5, T2.C
unnamed: C24.2, U7.56 (VCAP)
unnamed: J1.5, K2.1
unnamed: LED2.A, R38.2
unnamed: LED1.A, R25.2
unnamed: D3.A, F3.2, T3.3 (D)
unnamed: C12.2, U5.9 (SS_TR)
unnamed: L1.P$1 (1), U5.1 (SW), U5.2 (SW), U5.3 (SW)
unnamed: C20.1, L2.1, U7.19 (AVDD)
unnamed: R20.2, R21.1, T3.1 (G)
unnamed: R21.2, T4.3 (D)
PIN3: U7.42 (RTCC/DMLN/RP2/CN53/RD8)
PIN6: U7.45 (RP12/GD7/CN56/RD11)
PIN7: U7.46 (DMH/RP11/INT0/CN49/RD0)
PIN8: U7.47 (SOSCI/C3IND/CN1/RC13)
PIN9/WATCHDOG: R26.2, U7.48 (SOSCO/SCLKI/T1CK/C3INC/RPI37/CN0/RC14)
PIN10: U7.49 (VCPCON/RP24/GD9/VBUSCHG/CN50/RD1)
PIN11: U7.50 (DPH/RP23/CN51/RD2)
PIN12: U7.51 (RP22/GEN/CN52/RD3)
PIN13: U7.52 (RP25/GCLK/CN13/RD4)
PIN14: U7.53 (RP20/GPWR/CN14/RD5)
PIN15: U7.54 (C3INB/CN15/RD6)
PIN16: U7.55 (C3INA/SESSEND/CN16/RD7)
PIN17: U7.58 (GD10/VBUSST/VCMPST1/VBUSVLD/CN68/RF0)
PIN18: U7.59 (GD11/VCMPST2/SESSVLD/CN69/RF1)
PIN19: U7.60 (GD0/CN58/RE0)
PIN20: U7.61 (GD1/CN59/RE1)
PIN21: U7.62 (GD2/CN60/RE2)
PIN22: U7.63 (GD3/CN61/RE3)
PIN23: U7.64 (HSYNC/CN62/RE4)
PIN24: U7.1 (VSYNC/CN63/RE5)
PIN27: U7.4 (C1IND/RP21/CN8/RG6)
PIN28: U7.5 (C1INC/RP26/CN9/RG7)
PIN29: U7.6 (C2IND/RP19/GD14/CN10/RG8)
PIN30: U7.8 (C2INC/RP27/GD15/CN11/RG9)
PIN31: U7.11 (PGEC3/AN5/C1INA/VBUSON/RP18/CN7/RB5)
PIN32: U7.12 (PGED3/AN4/C1INB/USBOEN/RP28/CN6/RB4)
PIN33: U7.13 (AN3/C2INA/VPIO/CN5/RB3)
PIN34: U7.14 (AN2/C2INB/VMIO/RP13/CN4/RB2)
PIN35: U7.15 (PGEC1/AN1/VREF-/RP1/CN3/RB1)
PIN36: U7.16 (PGED1/AN0/VREF+/RP0/CN2/RB0)
PIN37/PGC: JP4.5, U7.17 (PGEC2/AN6/RP6/CN24/RB6)
PIN38/PGD: JP4.4, U7.18 (PGED2/AN7/RP7/RCV/CN25/RB7)
PIN39: U7.21 (AN8/RP8/CN26/RB8)
PIN40/ANEMOMETER_SWITCH: R12.1, U7.22 (AN9/RP9/CN27/RB9)
PIN41/AZIMUTH: R5.1, U7.23 (TMS/CVREF/AN10/CN28/RB10)
PIN42/SUPPLY: R16.2, R17.1, U7.24 (TDO/AN11/CN29/RB11)
PIN43: U7.27 (TCK/AN12/CTEDG2/CN30/RB12)
PIN44: U7.28 (TDI/AN13/CTEDG1/CN31/RB13)
PIN45/REL1: R18.1, U7.29 (AN14/CTPLS/RP14/CN32/RB14)
PIN46/REL2: R22.1, U7.30 (AN15/RP29/REFO/CN12/RB15)
SCL1: R7.1, R30.2, SV1.3, U1.6 (SY), U7.44 (SCL1/RP3/GD6/CN55/RD10)
SCL2: R11.1, R31.2, SV3.3, U3.6 (SY), U7.32 (SCL2/RP17/GD5/CN18/RF5)
SCL3: R9.1, R32.2, SV2.3, U2.6 (SY), U6.8 (SCL), U7.2 (GD12/SCL3/CN64/RE6)
SDA1: R6.1, R33.2, SV1.2, U1.3 (SX), U7.43 (DPLN/SDA1/RP4/GD8/CN54/RD9)
SDA2: R10.1, R34.2, SV3.2, U3.3 (SX), U7.31 (SDA2/RP10/GD4/CN17/RF4)
SDA3: R8.1, R29.2, SV2.2, U2.3 (SX), U6.7 (SDA), U7.3 (GD13/SDA3/CN65/RE7)
TEMP1/SCL1: J4.5, R7.2, R13.2, U1.7 (LY)
TEMP2/SCL2: J5.5, R9.2, R14.2, U2.7 (LY)
TEMP3/SCL3: J6.5, R11.2, R15.2, U3.7 (LY)
USB+: J7.D-, U7.36 (D-/CN84/RG3)
USB-: J7.D+, U7.37 (D+/CN83/RG2)
USBID: J7.ID (USBID), R37.1, U7.33 (RP16/USBID/CN71/RF3)
V+: F1.2, K1.1, K2.7 (S)
VBUS: F3.1, J7.VBUS, U7.34 (VBUS/RF7)

Notes on the sheet:
http://www.eeweb.com/toolbox/twisted-pair
ANEMOMETER
SENSOR B
SENSOR A
SENSOR C
I2C C
I2C A
I2C B
Ytai Ben-tsvi
yellow
red
0.75A
29mOhm, 4A

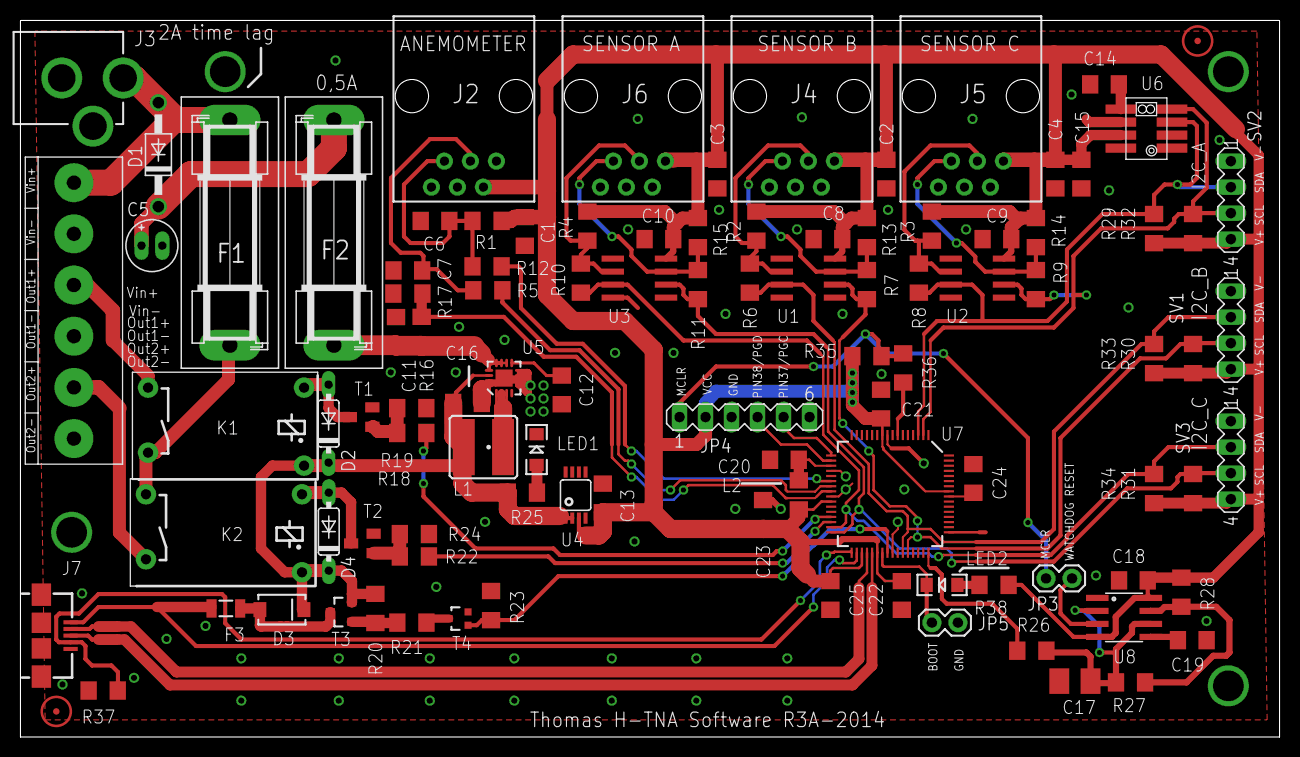
[picture p75: board [B]Main board v1.3.brd from above]

Board: 2 copper layers, 123.0 x 70.0 mm, 104 parts (0 on the bottom side), 57 nets.
