edarn/kryp-client/(commit log)

2013-09-01 Initial upload
    [proguard.cfg]
2013-10-07 Fixed bug when sending data to server.
    [Helper.java]
2013-10-16 A more failsafe client
    [Helper.java]
2013-11-08 Fix null check in Helper.Destroy
    [Helper.java]
2013-12-15 battery and temp reading and other stuff
2013-12-17 modified time, added temp and battery
2013-12-19 New and modified IOIOLib - pwm changes
    [proguard.cfg]
2014-01-13 Updated to IOIO lib version 5.0
    [proguard.cfg]
2014-01-21 I2C Sensor
2014-01-21 Updated to IOIO Lib v5.1
    [proguard.cfg]
2014-01-21 upates to use different sensors
2014-01-21 Two working sensors
2014-01-28 Bugfix - update name and position from Setup
    [Helper.java]
2014-02-04 Cleanup and fix setup
    [Helper.java]
2014-02-19 Modified UI Removed Debugger Activity Temporary commented away all Surfvind code in service Added support for Starting/Stopping fan for new circuits.
2014-02-21 Fan working
2014-03-18 Error handling when sending data
    [Helper.java]
2014-07-31 Multiple fixes
    Catching all uncaught exceptions.
    Added logging to file.
    Refactored and cleaned up.
    [Helper.java]
2014-08-01 Renamed folder and Project
    [proguard.cfg]
2014-09-21 Who knows what fixes this is. :)
    [Helper.java]
2014-10-17 Project restructure
    Adding Web project VindInfo and Surfvind.
    Adding support for Gradle/Android Studio.
    [proguard.cfg]
2014-10-29 Restructuring project again
    [proguard.cfg]
2015-01-17 Fix calculation error in temperature!!
    [Helper.java]
2015-01-28 testing rotate of sensor pointers
2015-01-28 Adding PCB with watchdog, Gerbers and BOM. Revision 2 of BOM was sent to china for manufacturing.
    [BOM_Main board v1.3 rev0.1.xls, BOM_Main board v1.3 rev0.2.xls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]
2015-01-28 Cleanup some and add basic support for humidity sensor in SurfVind
2015-02-11 Adding power, temp and humidity to Surfvind.se
